mattlokes/mqttDisplay/README.md

# mqttDisplay

## Schematic / BOM
* [BOM](https://htmlpreview.github.io/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)
* [Schematic](https://github.com/mattlokes/mqttDisplay/blob/main/pcb/mqttDisplay/ibom/mqttDisplay.pdf)
