mattlokes/mqttDisplay/case/main.3mf

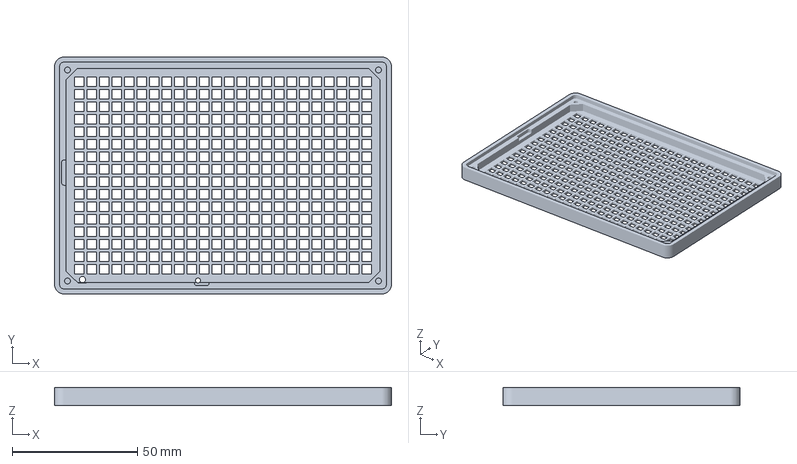
[picture p1: CAD file, 2021-03-28]
case/main.3mf
134.8 x 94.8 x 7.20 mm
