mattlokes/mqttDisplay/case/baffle.stl

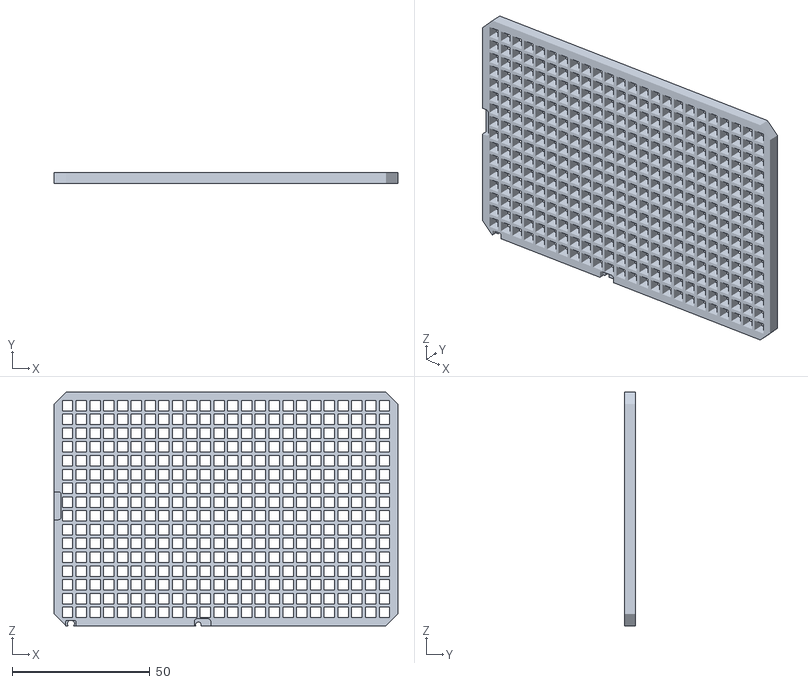
[picture p2: CAD file, 2021-03-28]
case/baffle.stl
124.8 x 4.00 x 84.8
