mattlokes/mqttDisplay/case/stand_right.stl

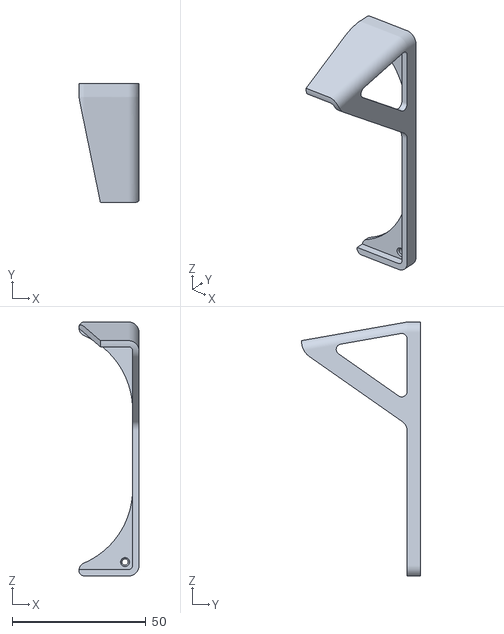
[picture p3: CAD file, 2021-03-28]
case/stand_right.stl
22.4 x 44.4 x 94.8
