mattlokes/mqttDisplay/case/stand.3mf

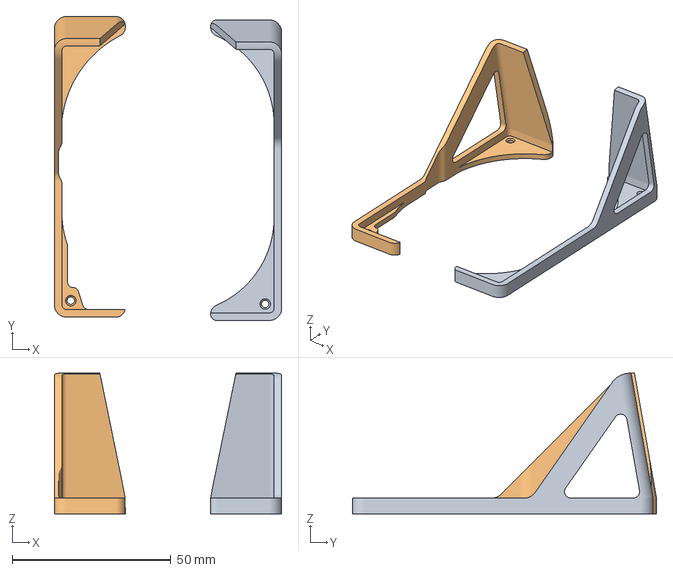
[picture p4: CAD file, 2021-03-28]
case/stand.3mf
71.7 x 95.9 x 44.4 mm
stand_right.stl
stand_left.stl
