mattlokes/mqttDisplay/(list of files, cad)

Other CAD files:
case/stand_left.stl
case/main.stl
