mattlokes/mqttDisplay/pcb/mqttDisplay/mqttDisplay.kicad_pcb

## KiCad design pcb/mqttDisplay/mqttDisplay.kicad_pcb (2021-03-14)

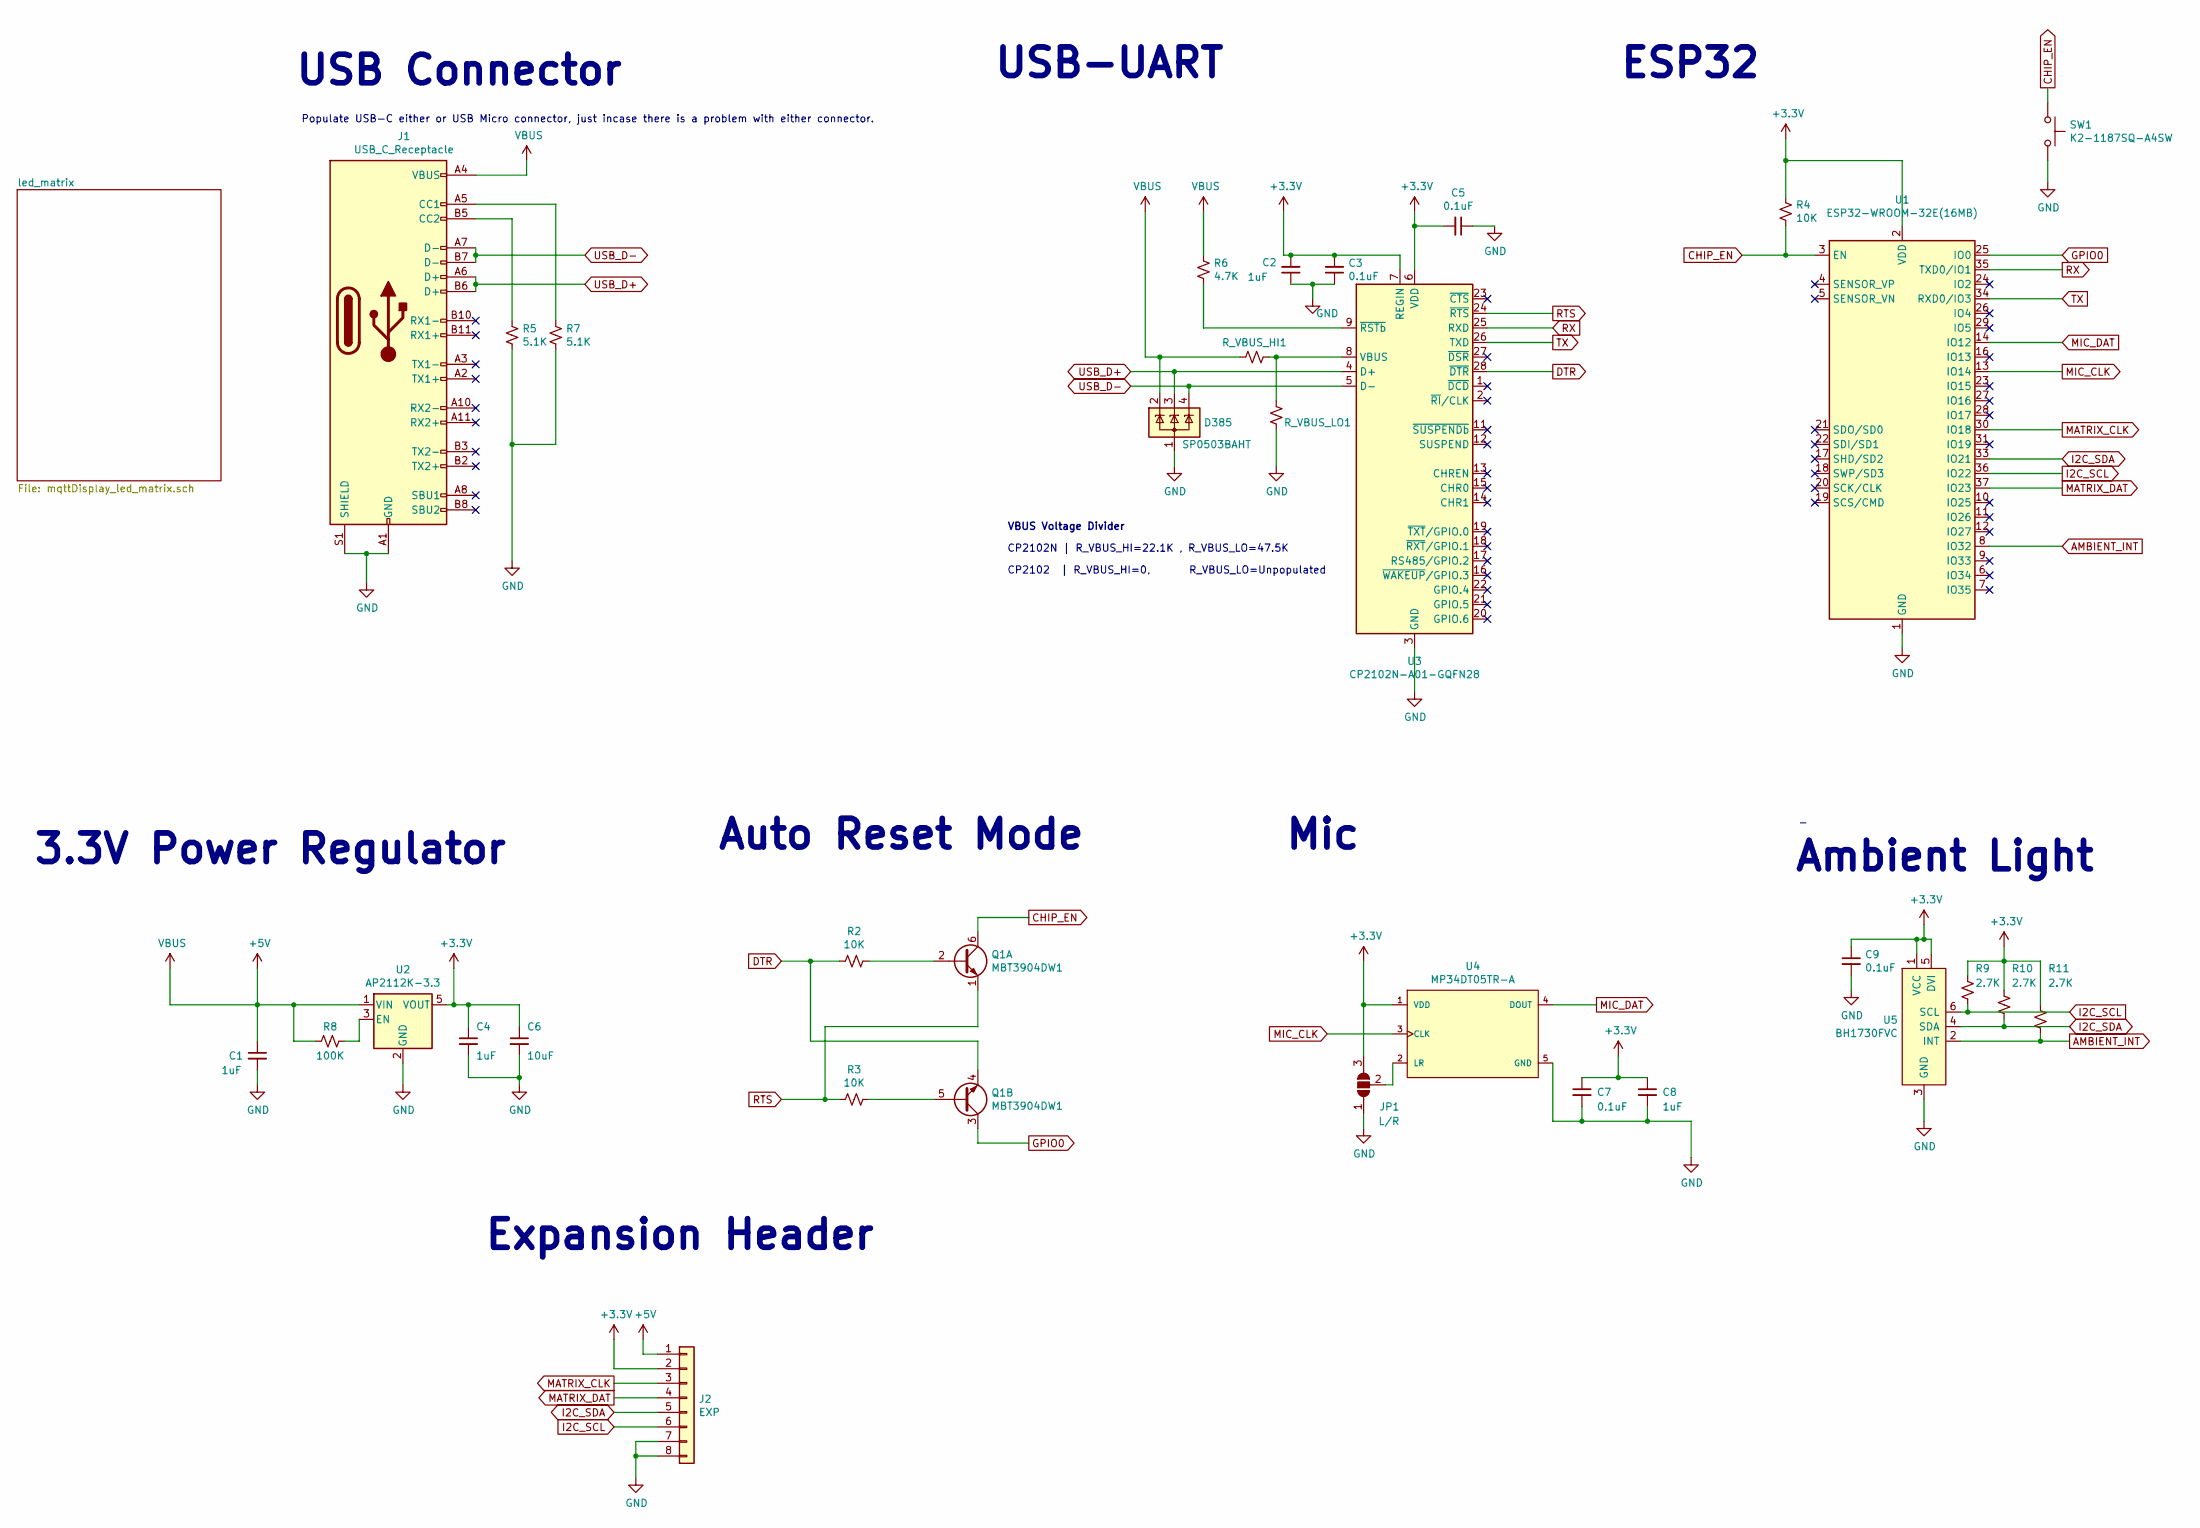
[picture p5: schematic mqttDisplay.sch]

Parts:
C1, C2, C4, C8: 1uF; C_0603_1608Metric_Pad1.08x0.95mm_HandSolder; LCSC# C272771
C3, C5, C7, C9: 0.1uF; C_0603_1608Metric_Pad1.08x0.95mm_HandSolder; LCSC# C478888
C6: 10uF; C_0603_1608Metric_Pad1.08x0.95mm_HandSolder; LCSC# C19702
D385: SP0503BAHT; SOT-143; LCSC# C7074
J1: USB_C_Receptacle; USB_C_Receptacle_JING_EXTENSION_C168704_USB2_VERTICAL; LCSC# C168704
J2: EXP; PinHeader_1x08_P2.54mm_Vertical; LCSC# C50981
JP1: L/R; SolderJumper-3_P1.3mm_Open_RoundedPad1.0x1.5mm; LCSC# --
Q1: MBT3904DW1; SOT-363_SC-70-6; LCSC# C110150
R2, R3, R4: 10K; R_0603_1608Metric_Pad0.98x0.95mm_HandSolder; LCSC# C441897
R5, R7: 5.1K; R_0603_1608Metric_Pad0.98x0.95mm_HandSolder; LCSC# C14677
R6: 4.7K; R_0603_1608Metric_Pad0.98x0.95mm_HandSolder; LCSC# C163915
R8: 100K; R_0603_1608Metric_Pad0.98x0.95mm_HandSolder; LCSC# C189597
R9, R10, R11: 2.7K; R_0603_1608Metric_Pad0.98x0.95mm_HandSolder; LCSC# C403121
R_VBUS_HI1: 0; R_0603_1608Metric_Pad0.98x0.95mm_HandSolder; LCSC# C100044
R_VBUS_LO1: 0; R_0603_1608Metric_Pad0.98x0.95mm_HandSolder; LCSC# C100044
SW1: K2-1187SQ-A4SW; SW_SPST_TL3342; LCSC# C92584
U1: ESP32-WROOM-32E(16MB); ESP32-WROOM-32; LCSC# C701343
U2: AP2112K-3.3; SOT-23-5; LCSC# C51118
U3: CP2102N-A01-GQFN28; QFN-28-1EP_5x5mm_P0.5mm_EP3.35x3.35mm; LCSC# C6568
U4: MP34DT05TR-A; STMicroelectronics-HCLGA-DM00231908-0-3-MFG; mouser part number 511-MP34DT05TR-A; digikey description MICROPHONE MEMS DIGITAL PDM OMNI
U5: BH1730FVC; WSOF6; LCSC# C79616

Connections:
+3V3: C2.2, C3.2, C4.1, C5.2, C6.1, C7.1, C8.1, C9.1, J2.2, JP1.3 (B), R4.1, R9.1, R10.1, R11.1, U1.2 (VDD), U2.5 (VOUT), U3.6 (VDD), U3.7 (REGIN), U4.1 (VDD), U5.1 (VCC), U5.5 (DVI)
+5V: C1.1, D385.2 (K), J1.A4 (VBUS), J1.A9 (VBUS), J1.B4 (VBUS), J1.B9 (VBUS), J2.1, R6.1, R8.2, R_VBUS_HI1.2, U2.1 (VIN); also elsewhere on the board
AMBIENT_INT: R11.2, U1.8 (IO32), U5.2 (INT)
CHIP_EN: Q1.6 (C1), R4.2, SW1.1, U1.3 (EN)
DTR: Q1.4 (E2), R2.2, U3.28 (~DTR)
GND: C1.2, C2.1, C3.1, C4.2, C5.1, C6.2, C7.2, C8.2, C9.2, D385.1 (A), J1.A1 (GND), J1.A12 (GND), J1.B1 (GND), J1.B12 (GND), J1.S1 (SHIELD), J1.SHIELD, J2.7, J2.8, JP1.1 (A), R5.1, R7.1, R_VBUS_LO1.2, SW1.2, U1.1 (GND), U1.15 (GND), U1.38 (GND), U1.39 (GND), U2.2 (GND), U3.3 (GND), U3.29 (GND), U4.5 (GND), U5.3 (GND); also elsewhere on the board
GPIO0: Q1.3 (C2), U1.25 (IO0)
I2C_SCL: J2.6, R9.2, U1.36 (IO22), U5.6 (SCL)
I2C_SDA: J2.5, R10.2, U1.33 (IO21), U5.4 (SDA)
MATRIX_CLK: J2.3, U1.30 (IO18); also elsewhere on the board
MATRIX_DAT: J2.4, U1.37 (IO23); also elsewhere on the board
MIC_CLK: U1.13 (IO14), U4.3 (CLK)
MIC_DAT: U1.14 (IO12), U4.4 (DOUT)
unnamed: J1.A5 (CC1), R7.2
unnamed: J1.B5 (CC2), R5.2
unnamed: JP1.2 (C), U4.2 (LR)
unnamed: Q1.2 (B1), R2.1
unnamed: Q1.5 (B2), R3.1
unnamed: R6.2, U3.9 (~RSTb)
unnamed: R8.1, U2.3 (EN)
unnamed: R_VBUS_HI1.1, R_VBUS_LO1.1, U3.8 (VBUS)
RTS: Q1.1 (E1), R3.2, U3.24 (~RTS)
RX: U1.35 (TXD0/IO1), U3.25 (RXD)
TX: U1.34 (RXD0/IO3), U3.26 (TXD)
USB_D+: D385.3 (K), J1.A6 (D+), J1.B6 (D+), U3.4 (D+)
USB_D-: D385.4 (K), J1.A7 (D-), J1.B7 (D-), U3.5 (D-)

Notes on the sheet:
Expansion Header
Ambient Light
Mic
ESP32
Auto Reset Mode
CP2102 | R_VBUS_HI=0, R_VBUS_LO=Unpopulated
CP2102N | R_VBUS_HI=22.1K , R_VBUS_LO=47.5K
VBUS Voltage Divider
USB-UART
USB Connector
Populate USB-C either or USB Micro connector, just incase there is a problem with either connector.
3.3V Power Regulator
