mattlokes/mqttDisplay/pcb/mqttDisplay/mqttDisplay.kicad_pcb

## KiCad design pcb/mqttDisplay/mqttDisplay.kicad_pcb (continued)

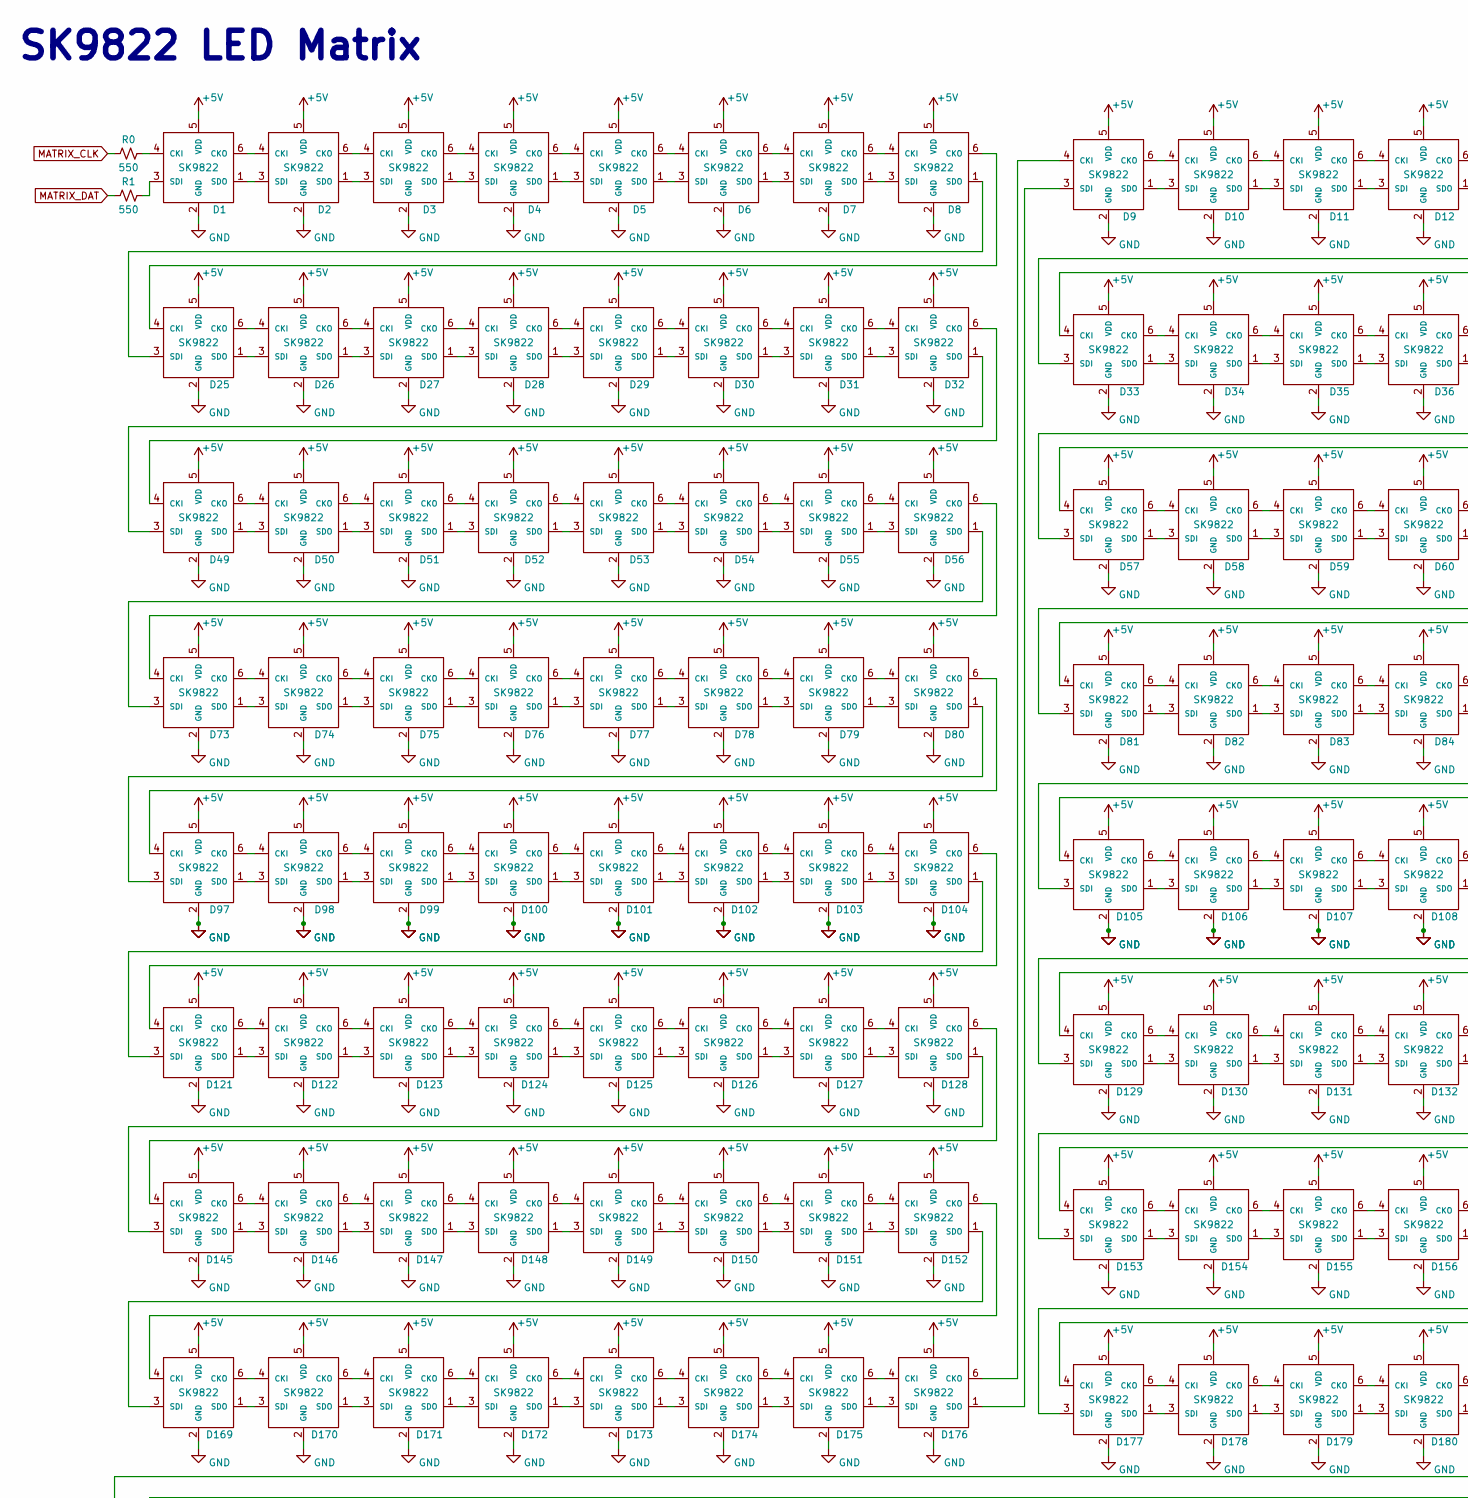
[picture p6: schematic mqttDisplay_led_matrix.sch, part in row 1, column 1]

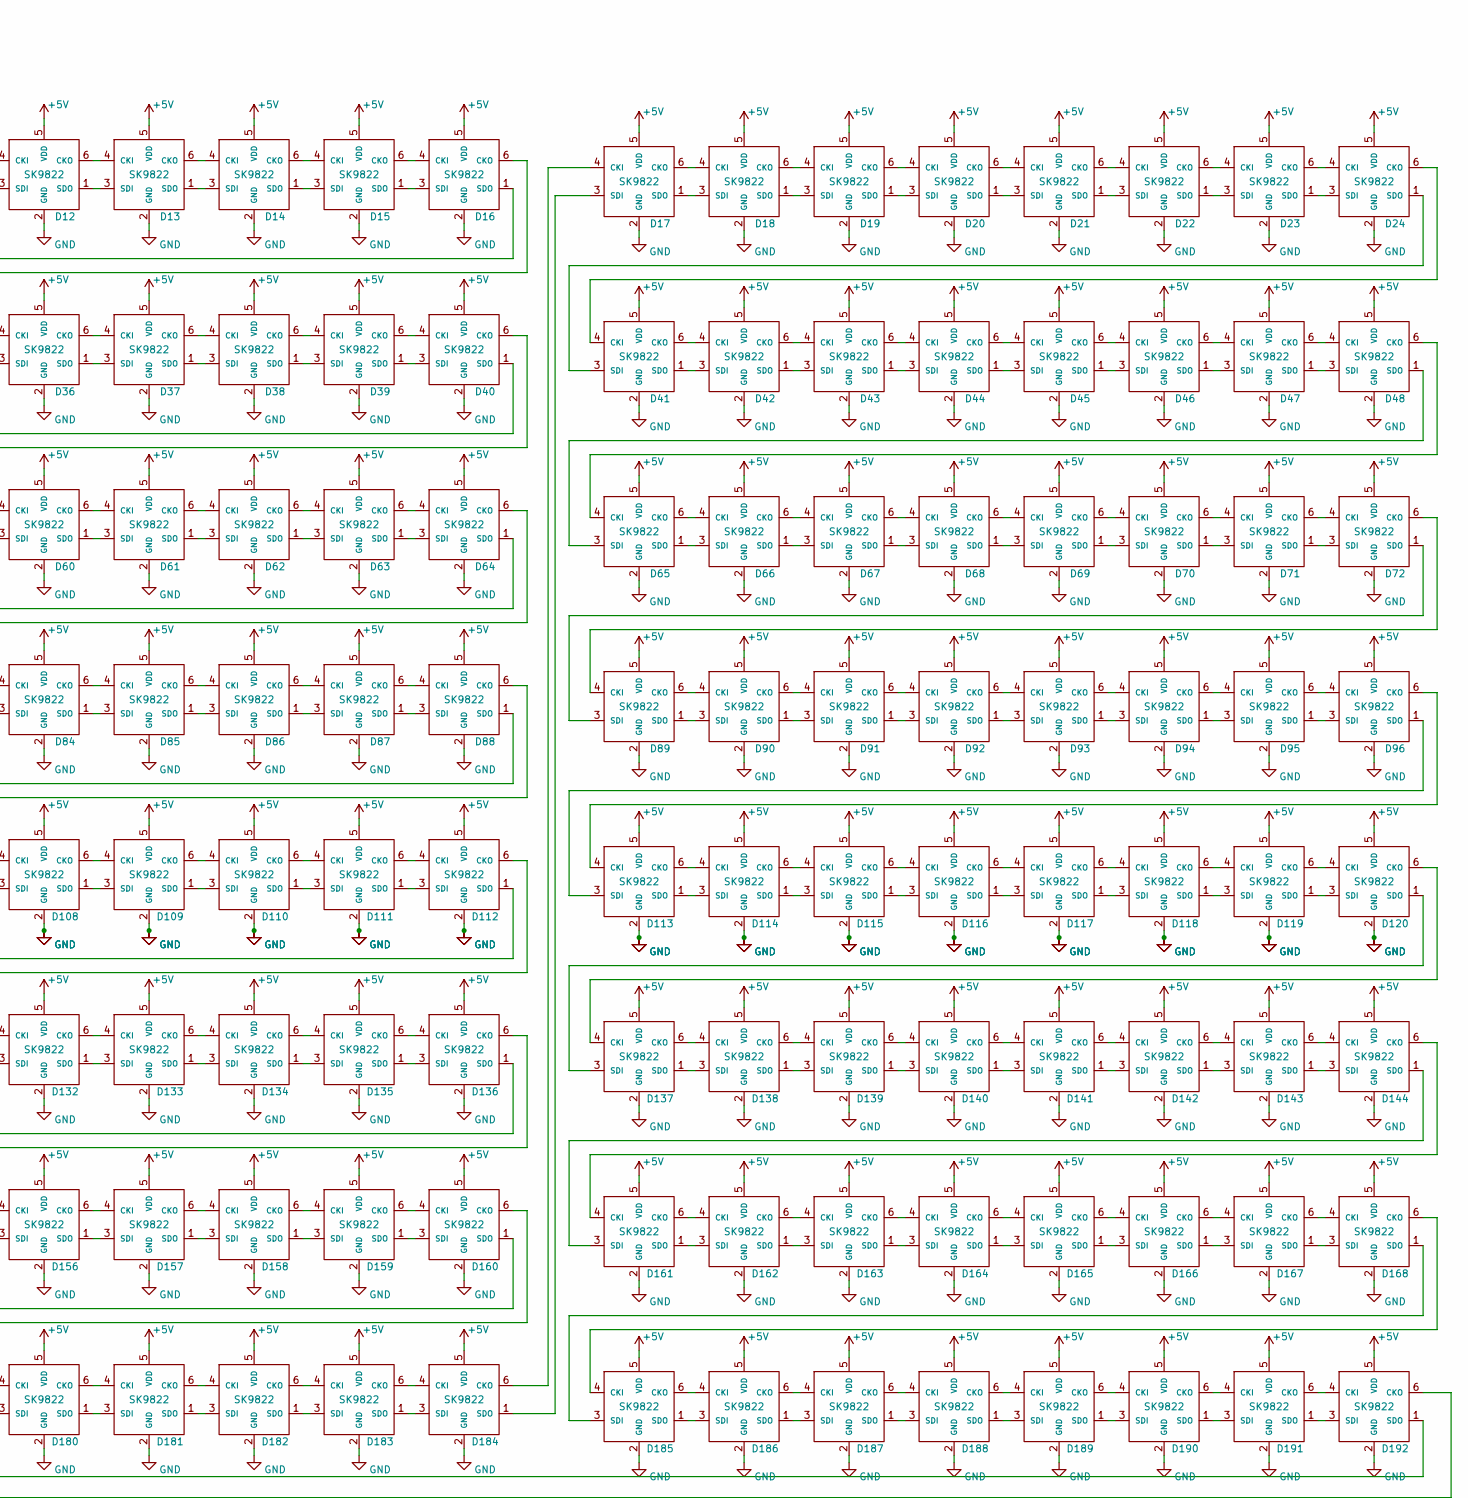
[picture p7: schematic mqttDisplay_led_matrix.sch, part in row 1, column 2]

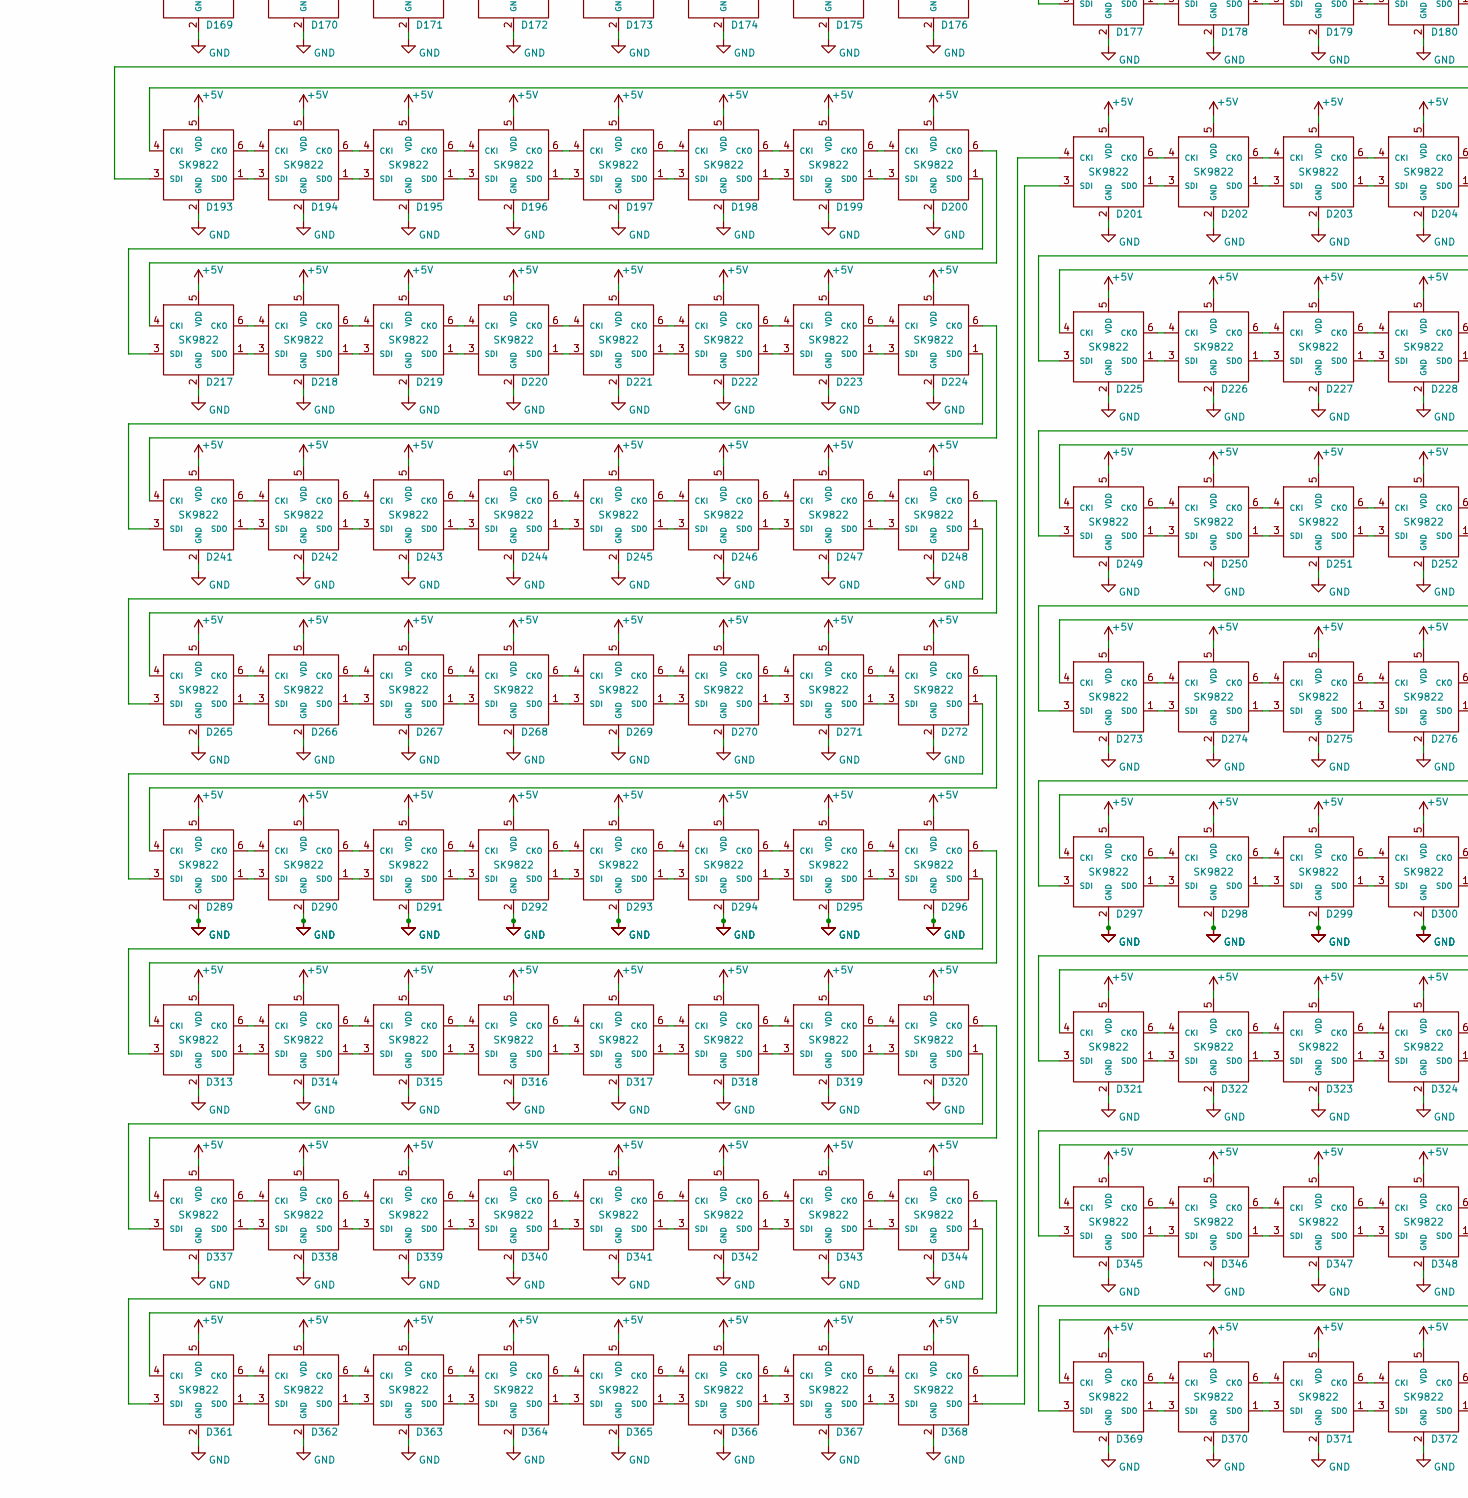
[picture p8: schematic mqttDisplay_led_matrix.sch, part in row 2, column 1]

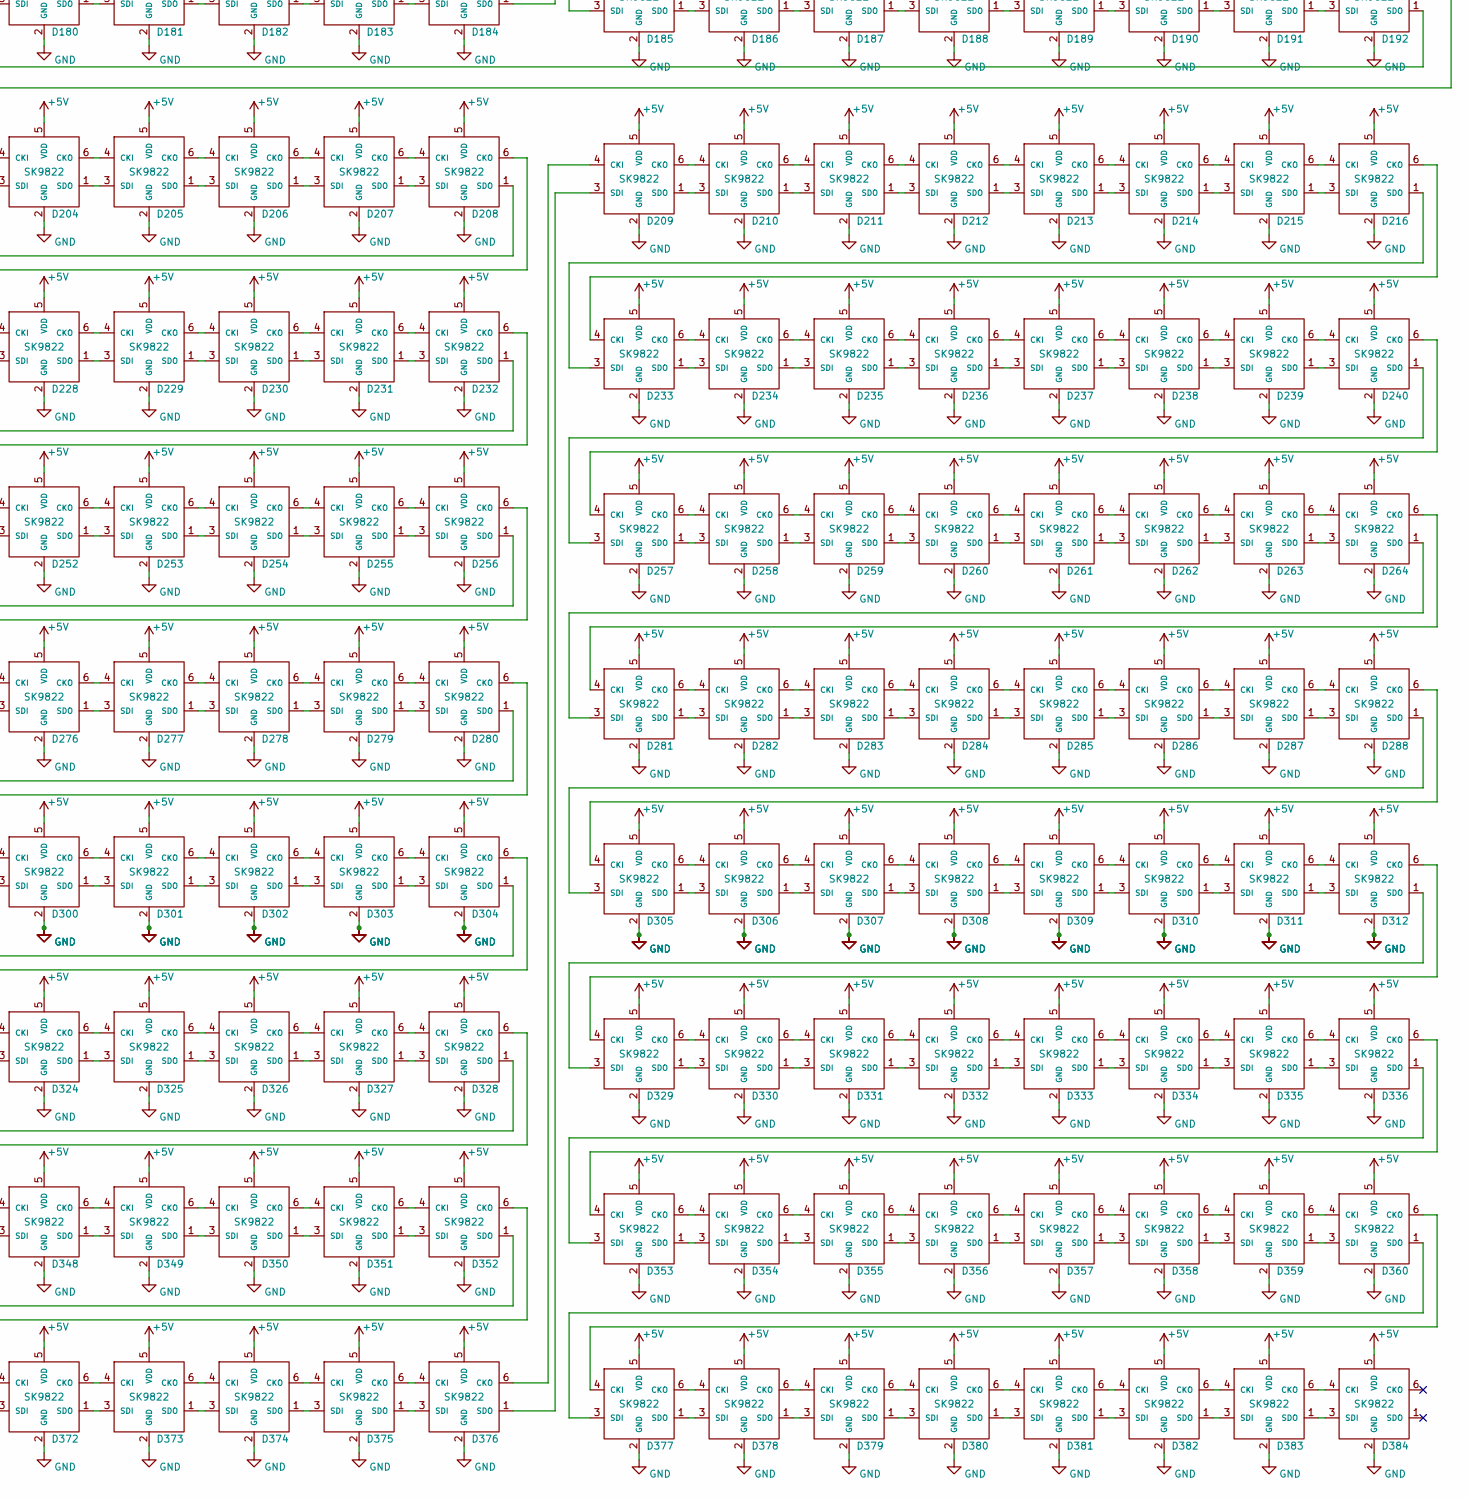
[picture p9: schematic mqttDisplay_led_matrix.sch, part in row 2, column 2]

Parts:
D1, D2, D3, D4, D5, D6, D7, D8, D9, D10, D11, D12, D13, D14, D15, D16, D17, D18, D19, D20, D21, D22, D23, D24, D25, D26, D27, D28, D29, D30, D31, D32, D33, D34, D35, D36, D37, D38, D39, D40, D41, D42, D43, D44, D45, D46, D47, D48, D49, D50, D51, D52, D53, D54, D55, D56, D57, D58, D59, D60, D61, D62, D63, D64, D65, D66, D67, D68, D69, D70, D71, D72, D73, D74, D75, D76, D77, D78, D79, D80, D81, D82, D83, D84, D85, D86, D87, D88, D89, D90, D91, D92, D93, D94, D95, D96, D97, D98, D99, D100, D101, D102, D103, D104, D105, D106, D107, D108, D109, D110, D111, D112, D113, D114, D115, D116, D117, D118, D119, D120, D121, D122, D123, D124, D125, D126, D127, D128, D129, D130, D131, D132, D133, D134, D135, D136, D137, D138, D139, D140, D141, D142, D143, D144, D145, D146, D147, D148, D149, D150, D151, D152, D153, D154, D155, D156, D157, D158, D159, D160, D161, D162, D163, D164, D165, D166, D167, D168, D169, D170, D171, D172, D173, D174, D175, D176, D177, D178, D179, D180, D181, D182, D183, D184, D185, D186, D187, D188, D189, D190, D191, D192, D193, D194, D195, D196, D197, D198, D199, D200, D201, D202, D203, D204, D205, D206, D207, D208, D209, D210, D211, D212, D213, D214, D215, D216, D217, D218, D219, D220, D221, D222, D223, D224, D225, D226, D227, D228, D229, D230, D231, D232, D233, D234, D235, D236, D237, D238, D239, D240, D241, D242, D243, D244, D245, D246, D247, D248, D249, D250, D251, D252, D253, D254, D255, D256, D257, D258, D259, D260, D261, D262, D263, D264, D265, D266, D267, D268, D269, D270, D271, D272, D273, D274, D275, D276, D277, D278, D279, D280, D281, D282, D283, D284, D285, D286, D287, D288, D289, D290, D291, D292, D293, D294, D295, D296, D297, D298, D299, D300, D301, D302, D303, D304, D305, D306, D307, D308, D309, D310, D311, D312, D313, D314, D315, D316, D317, D318, D319, D320, D321, D322, D323, D324, D325, D326, D327, D328, D329, D330, D331, D332, D333, D334, D335, D336, D337, D338, D339, D340, D341, D342, D343, D344, D345, D346, D347, D348, D349, D350, D351, D352, D353, D354, D355, D356, D357, D358, D359, D360, D361, D362, D363, D364, D365, D366, D367, D368, D369, D370, D371, D372, D373, D374, D375, D376, D377, D378, D379, D380, D381, D382, D383, D384: SK9822; LED_SK9822_2020; LCSC# --
R0, R1: 550; R_0603_1608Metric_Pad0.98x0.95mm_HandSolder; LCSC# C308281

Connections:
+5V: D1.5 (VDD), D2.5 (VDD), D3.5 (VDD), D4.5 (VDD), D5.5 (VDD), D6.5 (VDD), D7.5 (VDD), D8.5 (VDD), D9.5 (VDD), D10.5 (VDD), D11.5 (VDD), D12.5 (VDD), D13.5 (VDD), D14.5 (VDD), D15.5 (VDD), D16.5 (VDD), D17.5 (VDD), D18.5 (VDD), D19.5 (VDD), D20.5 (VDD), D21.5 (VDD), D22.5 (VDD), D23.5 (VDD), D24.5 (VDD), D25.5 (VDD), D26.5 (VDD), D27.5 (VDD), D28.5 (VDD), D29.5 (VDD), D30.5 (VDD), D31.5 (VDD), D32.5 (VDD), D33.5 (VDD), D34.5 (VDD), D35.5 (VDD), D36.5 (VDD), D37.5 (VDD), D38.5 (VDD), D39.5 (VDD), D40.5 (VDD), D41.5 (VDD), D42.5 (VDD), D43.5 (VDD), D44.5 (VDD), D45.5 (VDD), D46.5 (VDD), D47.5 (VDD), D48.5 (VDD), D49.5 (VDD), D50.5 (VDD), D51.5 (VDD), D52.5 (VDD), D53.5 (VDD), D54.5 (VDD), D55.5 (VDD), D56.5 (VDD), D57.5 (VDD), D58.5 (VDD), D59.5 (VDD), D60.5 (VDD), D61.5 (VDD), D62.5 (VDD), D63.5 (VDD), D64.5 (VDD), D65.5 (VDD), D66.5 (VDD), D67.5 (VDD), D68.5 (VDD), D69.5 (VDD), D70.5 (VDD), D71.5 (VDD), D72.5 (VDD), D73.5 (VDD), D74.5 (VDD), D75.5 (VDD), D76.5 (VDD), D77.5 (VDD), D78.5 (VDD), D79.5 (VDD), D80.5 (VDD), D81.5 (VDD), D82.5 (VDD), D83.5 (VDD), D84.5 (VDD), D85.5 (VDD), D86.5 (VDD), D87.5 (VDD), D88.5 (VDD), D89.5 (VDD), D90.5 (VDD), D91.5 (VDD), D92.5 (VDD), D93.5 (VDD), D94.5 (VDD), D95.5 (VDD), D96.5 (VDD), D97.5 (VDD), D98.5 (VDD), D99.5 (VDD), D100.5 (VDD), D101.5 (VDD), D102.5 (VDD), D103.5 (VDD), D104.5 (VDD), D105.5 (VDD), D106.5 (VDD), D107.5 (VDD), D108.5 (VDD), D109.5 (VDD), D110.5 (VDD), D111.5 (VDD), D112.5 (VDD), D113.5 (VDD), D114.5 (VDD), D115.5 (VDD), D116.5 (VDD), D117.5 (VDD), D118.5 (VDD), D119.5 (VDD), D120.5 (VDD), D121.5 (VDD), D122.5 (VDD), D123.5 (VDD), D124.5 (VDD), D125.5 (VDD), D126.5 (VDD), D127.5 (VDD), D128.5 (VDD), D129.5 (VDD), D130.5 (VDD), D131.5 (VDD), D132.5 (VDD), D133.5 (VDD), D134.5 (VDD), D135.5 (VDD), D136.5 (VDD), D137.5 (VDD), D138.5 (VDD), D139.5 (VDD), D140.5 (VDD), D141.5 (VDD), D142.5 (VDD), D143.5 (VDD), D144.5 (VDD), D145.5 (VDD), D146.5 (VDD), D147.5 (VDD), D148.5 (VDD), D149.5 (VDD), D150.5 (VDD), D151.5 (VDD), D152.5 (VDD), D153.5 (VDD), D154.5 (VDD), D155.5 (VDD), D156.5 (VDD), D157.5 (VDD), D158.5 (VDD), D159.5 (VDD), D160.5 (VDD), D161.5 (VDD), D162.5 (VDD), D163.5 (VDD), D164.5 (VDD), D165.5 (VDD), D166.5 (VDD), D167.5 (VDD), D168.5 (VDD), D169.5 (VDD), D170.5 (VDD), D171.5 (VDD), D172.5 (VDD), D173.5 (VDD), D174.5 (VDD), D175.5 (VDD), D176.5 (VDD), D177.5 (VDD), D178.5 (VDD), D179.5 (VDD), D180.5 (VDD), D181.5 (VDD), D182.5 (VDD), D183.5 (VDD), D184.5 (VDD), D185.5 (VDD), D186.5 (VDD), D187.5 (VDD), D188.5 (VDD), D189.5 (VDD), D190.5 (VDD), D191.5 (VDD), D192.5 (VDD), D193.5 (VDD), D194.5 (VDD), D195.5 (VDD), D196.5 (VDD), D197.5 (VDD), D198.5 (VDD), D199.5 (VDD), D200.5 (VDD), D201.5 (VDD), D202.5 (VDD), D203.5 (VDD), D204.5 (VDD), D205.5 (VDD), D206.5 (VDD), D207.5 (VDD), D208.5 (VDD), D209.5 (VDD), D210.5 (VDD), D211.5 (VDD), D212.5 (VDD), D213.5 (VDD), D214.5 (VDD), D215.5 (VDD), D216.5 (VDD), D217.5 (VDD), D218.5 (VDD), D219.5 (VDD), D220.5 (VDD), D221.5 (VDD), D222.5 (VDD), D223.5 (VDD), D224.5 (VDD), D225.5 (VDD), D226.5 (VDD), D227.5 (VDD), D228.5 (VDD), D229.5 (VDD), D230.5 (VDD), D231.5 (VDD), D232.5 (VDD), D233.5 (VDD), D234.5 (VDD), D235.5 (VDD), D236.5 (VDD), D237.5 (VDD), D238.5 (VDD), D239.5 (VDD), D240.5 (VDD), D241.5 (VDD), D242.5 (VDD), D243.5 (VDD), D244.5 (VDD), D245.5 (VDD), D246.5 (VDD), D247.5 (VDD), D248.5 (VDD), D249.5 (VDD), D250.5 (VDD), D251.5 (VDD), D252.5 (VDD), D253.5 (VDD), D254.5 (VDD), D255.5 (VDD), D256.5 (VDD), D257.5 (VDD), D258.5 (VDD), D259.5 (VDD), D260.5 (VDD), D261.5 (VDD), D262.5 (VDD), D263.5 (VDD), D264.5 (VDD), D265.5 (VDD), D266.5 (VDD), D267.5 (VDD), D268.5 (VDD), D269.5 (VDD), D270.5 (VDD), D271.5 (VDD), D272.5 (VDD), D273.5 (VDD), D274.5 (VDD), D275.5 (VDD), D276.5 (VDD), D277.5 (VDD), D278.5 (VDD), D279.5 (VDD), D280.5 (VDD), D281.5 (VDD), D282.5 (VDD), D283.5 (VDD), D284.5 (VDD), D285.5 (VDD), D286.5 (VDD), D287.5 (VDD), D288.5 (VDD), D289.5 (VDD), D290.5 (VDD), D291.5 (VDD), D292.5 (VDD), D293.5 (VDD), D294.5 (VDD), D295.5 (VDD), D296.5 (VDD), D297.5 (VDD), D298.5 (VDD), D299.5 (VDD), D300.5 (VDD), D301.5 (VDD), D302.5 (VDD), D303.5 (VDD), D304.5 (VDD), D305.5 (VDD), D306.5 (VDD), D307.5 (VDD), D308.5 (VDD), D309.5 (VDD), D310.5 (VDD), D311.5 (VDD), D312.5 (VDD), D313.5 (VDD), D314.5 (VDD), D315.5 (VDD), D316.5 (VDD), D317.5 (VDD), D318.5 (VDD), D319.5 (VDD), D320.5 (VDD), D321.5 (VDD), D322.5 (VDD), D323.5 (VDD), D324.5 (VDD), D325.5 (VDD), D326.5 (VDD), D327.5 (VDD), D328.5 (VDD), D329.5 (VDD), D330.5 (VDD), D331.5 (VDD), D332.5 (VDD), D333.5 (VDD), D334.5 (VDD), D335.5 (VDD), D336.5 (VDD), D337.5 (VDD), D338.5 (VDD), D339.5 (VDD), D340.5 (VDD), D341.5 (VDD), D342.5 (VDD), D343.5 (VDD), D344.5 (VDD), D345.5 (VDD), D346.5 (VDD), D347.5 (VDD), D348.5 (VDD), D349.5 (VDD), D350.5 (VDD), D351.5 (VDD), D352.5 (VDD), D353.5 (VDD), D354.5 (VDD), D355.5 (VDD), D356.5 (VDD), D357.5 (VDD), D358.5 (VDD), D359.5 (VDD), D360.5 (VDD), D361.5 (VDD), D362.5 (VDD), D363.5 (VDD), D364.5 (VDD), D365.5 (VDD), D366.5 (VDD), D367.5 (VDD), D368.5 (VDD), D369.5 (VDD), D370.5 (VDD), D371.5 (VDD), D372.5 (VDD), D373.5 (VDD), D374.5 (VDD), D375.5 (VDD), D376.5 (VDD), D377.5 (VDD), D378.5 (VDD), D379.5 (VDD), D380.5 (VDD), D381.5 (VDD), D382.5 (VDD), D383.5 (VDD), D384.5 (VDD); also elsewhere on the board
GND: D1.2 (GND), D2.2 (GND), D3.2 (GND), D4.2 (GND), D5.2 (GND), D6.2 (GND), D7.2 (GND), D8.2 (GND), D9.2 (GND), D10.2 (GND), D11.2 (GND), D12.2 (GND), D13.2 (GND), D14.2 (GND), D15.2 (GND), D16.2 (GND), D17.2 (GND), D18.2 (GND), D19.2 (GND), D20.2 (GND), D21.2 (GND), D22.2 (GND), D23.2 (GND), D24.2 (GND), D25.2 (GND), D26.2 (GND), D27.2 (GND), D28.2 (GND), D29.2 (GND), D30.2 (GND), D31.2 (GND), D32.2 (GND), D33.2 (GND), D34.2 (GND), D35.2 (GND), D36.2 (GND), D37.2 (GND), D38.2 (GND), D39.2 (GND), D40.2 (GND), D41.2 (GND), D42.2 (GND), D43.2 (GND), D44.2 (GND), D45.2 (GND), D46.2 (GND), D47.2 (GND), D48.2 (GND), D49.2 (GND), D50.2 (GND), D51.2 (GND), D52.2 (GND), D53.2 (GND), D54.2 (GND), D55.2 (GND), D56.2 (GND), D57.2 (GND), D58.2 (GND), D59.2 (GND), D60.2 (GND), D61.2 (GND), D62.2 (GND), D63.2 (GND), D64.2 (GND), D65.2 (GND), D66.2 (GND), D67.2 (GND), D68.2 (GND), D69.2 (GND), D70.2 (GND), D71.2 (GND), D72.2 (GND), D73.2 (GND), D74.2 (GND), D75.2 (GND), D76.2 (GND), D77.2 (GND), D78.2 (GND), D79.2 (GND), D80.2 (GND), D81.2 (GND), D82.2 (GND), D83.2 (GND), D84.2 (GND), D85.2 (GND), D86.2 (GND), D87.2 (GND), D88.2 (GND), D89.2 (GND), D90.2 (GND), D91.2 (GND), D92.2 (GND), D93.2 (GND), D94.2 (GND), D95.2 (GND), D96.2 (GND), D97.2 (GND), D98.2 (GND), D99.2 (GND), D100.2 (GND), D101.2 (GND), D102.2 (GND), D103.2 (GND), D104.2 (GND), D105.2 (GND), D106.2 (GND), D107.2 (GND), D108.2 (GND), D109.2 (GND), D110.2 (GND), D111.2 (GND), D112.2 (GND), D113.2 (GND), D114.2 (GND), D115.2 (GND), D116.2 (GND), D117.2 (GND), D118.2 (GND), D119.2 (GND), D120.2 (GND), D121.2 (GND), D122.2 (GND), D123.2 (GND), D124.2 (GND), D125.2 (GND), D126.2 (GND), D127.2 (GND), D128.2 (GND), D129.2 (GND), D130.2 (GND), D131.2 (GND), D132.2 (GND), D133.2 (GND), D134.2 (GND), D135.2 (GND), D136.2 (GND), D137.2 (GND), D138.2 (GND), D139.2 (GND), D140.2 (GND), D141.2 (GND), D142.2 (GND), D143.2 (GND), D144.2 (GND), D145.2 (GND), D146.2 (GND), D147.2 (GND), D148.2 (GND), D149.2 (GND), D150.2 (GND), D151.2 (GND), D152.2 (GND), D153.2 (GND), D154.2 (GND), D155.2 (GND), D156.2 (GND), D157.2 (GND), D158.2 (GND), D159.2 (GND), D160.2 (GND), D161.2 (GND), D162.2 (GND), D163.2 (GND), D164.2 (GND), D165.2 (GND), D166.2 (GND), D167.2 (GND), D168.2 (GND), D169.2 (GND), D170.2 (GND), D171.2 (GND), D172.2 (GND), D173.2 (GND), D174.2 (GND), D175.2 (GND), D176.2 (GND), D177.2 (GND), D178.2 (GND), D179.2 (GND), D180.2 (GND), D181.2 (GND), D182.2 (GND), D183.2 (GND), D184.2 (GND), D185.2 (GND), D186.2 (GND), D187.2 (GND), D188.2 (GND), D189.2 (GND), D190.2 (GND), D191.2 (GND), D192.2 (GND), D193.2 (GND), D194.2 (GND), D195.2 (GND), D196.2 (GND), D197.2 (GND), D198.2 (GND), D199.2 (GND), D200.2 (GND), D201.2 (GND), D202.2 (GND), D203.2 (GND), D204.2 (GND), D205.2 (GND), D206.2 (GND), D207.2 (GND), D208.2 (GND), D209.2 (GND), D210.2 (GND), D211.2 (GND), D212.2 (GND), D213.2 (GND), D214.2 (GND), D215.2 (GND), D216.2 (GND), D217.2 (GND), D218.2 (GND), D219.2 (GND), D220.2 (GND), D221.2 (GND), D222.2 (GND), D223.2 (GND), D224.2 (GND), D225.2 (GND), D226.2 (GND), D227.2 (GND), D228.2 (GND), D229.2 (GND), D230.2 (GND), D231.2 (GND), D232.2 (GND), D233.2 (GND), D234.2 (GND), D235.2 (GND), D236.2 (GND), D237.2 (GND), D238.2 (GND), D239.2 (GND), D240.2 (GND), D241.2 (GND), D242.2 (GND), D243.2 (GND), D244.2 (GND), D245.2 (GND), D246.2 (GND), D247.2 (GND), D248.2 (GND), D249.2 (GND), D250.2 (GND), D251.2 (GND), D252.2 (GND), D253.2 (GND), D254.2 (GND), D255.2 (GND), D256.2 (GND), D257.2 (GND), D258.2 (GND), D259.2 (GND), D260.2 (GND), D261.2 (GND), D262.2 (GND), D263.2 (GND), D264.2 (GND), D265.2 (GND), D266.2 (GND), D267.2 (GND), D268.2 (GND), D269.2 (GND), D270.2 (GND), D271.2 (GND), D272.2 (GND), D273.2 (GND), D274.2 (GND), D275.2 (GND), D276.2 (GND), D277.2 (GND), D278.2 (GND), D279.2 (GND), D280.2 (GND), D281.2 (GND), D282.2 (GND), D283.2 (GND), D284.2 (GND), D285.2 (GND), D286.2 (GND), D287.2 (GND), D288.2 (GND), D289.2 (GND), D290.2 (GND), D291.2 (GND), D292.2 (GND), D293.2 (GND), D294.2 (GND), D295.2 (GND), D296.2 (GND), D297.2 (GND), D298.2 (GND), D299.2 (GND), D300.2 (GND), D301.2 (GND), D302.2 (GND), D303.2 (GND), D304.2 (GND), D305.2 (GND), D306.2 (GND), D307.2 (GND), D308.2 (GND), D309.2 (GND), D310.2 (GND), D311.2 (GND), D312.2 (GND), D313.2 (GND), D314.2 (GND), D315.2 (GND), D316.2 (GND), D317.2 (GND), D318.2 (GND), D319.2 (GND), D320.2 (GND), D321.2 (GND), D322.2 (GND), D323.2 (GND), D324.2 (GND), D325.2 (GND), D326.2 (GND), D327.2 (GND), D328.2 (GND), D329.2 (GND), D330.2 (GND), D331.2 (GND), D332.2 (GND), D333.2 (GND), D334.2 (GND), D335.2 (GND), D336.2 (GND), D337.2 (GND), D338.2 (GND), D339.2 (GND), D340.2 (GND), D341.2 (GND), D342.2 (GND), D343.2 (GND), D344.2 (GND), D345.2 (GND), D346.2 (GND), D347.2 (GND), D348.2 (GND), D349.2 (GND), D350.2 (GND), D351.2 (GND), D352.2 (GND), D353.2 (GND), D354.2 (GND), D355.2 (GND), D356.2 (GND), D357.2 (GND), D358.2 (GND), D359.2 (GND), D360.2 (GND), D361.2 (GND), D362.2 (GND), D363.2 (GND), D364.2 (GND), D365.2 (GND), D366.2 (GND), D367.2 (GND), D368.2 (GND), D369.2 (GND), D370.2 (GND), D371.2 (GND), D372.2 (GND), D373.2 (GND), D374.2 (GND), D375.2 (GND), D376.2 (GND), D377.2 (GND), D378.2 (GND), D379.2 (GND), D380.2 (GND), D381.2 (GND), D382.2 (GND), D383.2 (GND), D384.2 (GND); also elsewhere on the board
MATRIX_CLK: R0.2; also elsewhere on the board
MATRIX_DAT: R1.2; also elsewhere on the board
unnamed: D1.1 (SDO), D2.3 (SDI)
unnamed: D1.3 (SDI), R1.1
unnamed: D1.4 (CKI), R0.1
unnamed: D1.6 (CKO), D2.4 (CKI)
unnamed: D2.1 (SDO), D3.3 (SDI)
unnamed: D2.6 (CKO), D3.4 (CKI)
unnamed: D3.1 (SDO), D4.3 (SDI)
unnamed: D3.6 (CKO), D4.4 (CKI)
unnamed: D4.1 (SDO), D5.3 (SDI)
unnamed: D4.6 (CKO), D5.4 (CKI)
unnamed: D5.1 (SDO), D6.3 (SDI)
unnamed: D5.6 (CKO), D6.4 (CKI)
unnamed: D6.1 (SDO), D7.3 (SDI)
unnamed: D6.6 (CKO), D7.4 (CKI)
unnamed: D7.1 (SDO), D8.3 (SDI)
unnamed: D7.6 (CKO), D8.4 (CKI)
unnamed: D10.1 (SDO), D11.3 (SDI)
unnamed: D9.1 (SDO), D10.3 (SDI)
unnamed: D9.6 (CKO), D10.4 (CKI)
unnamed: D10.6 (CKO), D11.4 (CKI)
unnamed: D11.1 (SDO), D12.3 (SDI)
unnamed: D11.6 (CKO), D12.4 (CKI)
unnamed: D12.1 (SDO), D13.3 (SDI)
unnamed: D12.6 (CKO), D13.4 (CKI)
unnamed: D13.1 (SDO), D14.3 (SDI)
unnamed: D13.6 (CKO), D14.4 (CKI)
unnamed: D14.1 (SDO), D15.3 (SDI)
unnamed: D14.6 (CKO), D15.4 (CKI)
unnamed: D15.1 (SDO), D16.3 (SDI)
unnamed: D15.6 (CKO), D16.4 (CKI)
unnamed: D16.1 (SDO), D33.3 (SDI)
unnamed: D16.6 (CKO), D33.4 (CKI)
unnamed: D17.1 (SDO), D18.3 (SDI)
unnamed: D17.3 (SDI), D184.1 (SDO)
unnamed: D17.4 (CKI), D184.6 (CKO)
unnamed: D17.6 (CKO), D18.4 (CKI)
unnamed: D18.1 (SDO), D19.3 (SDI)
unnamed: D18.6 (CKO), D19.4 (CKI)
unnamed: D19.1 (SDO), D20.3 (SDI)
unnamed: D19.6 (CKO), D20.4 (CKI)
unnamed: D20.1 (SDO), D21.3 (SDI)
unnamed: D20.6 (CKO), D21.4 (CKI)
unnamed: D21.1 (SDO), D22.3 (SDI)
unnamed: D21.6 (CKO), D22.4 (CKI)
unnamed: D22.1 (SDO), D23.3 (SDI)
unnamed: D22.6 (CKO), D23.4 (CKI)
unnamed: D23.1 (SDO), D24.3 (SDI)
unnamed: D23.6 (CKO), D24.4 (CKI)
unnamed: D24.1 (SDO), D41.3 (SDI)
unnamed: D24.6 (CKO), D41.4 (CKI)
unnamed: D25.1 (SDO), D26.3 (SDI)
unnamed: D8.1 (SDO), D25.3 (SDI)
unnamed: D8.6 (CKO), D25.4 (CKI)
unnamed: D25.6 (CKO), D26.4 (CKI)
unnamed: D26.1 (SDO), D27.3 (SDI)
unnamed: D26.6 (CKO), D27.4 (CKI)
unnamed: D27.1 (SDO), D28.3 (SDI)
unnamed: D27.6 (CKO), D28.4 (CKI)
unnamed: D28.1 (SDO), D29.3 (SDI)
unnamed: D28.6 (CKO), D29.4 (CKI)
unnamed: D29.1 (SDO), D30.3 (SDI)
unnamed: D29.6 (CKO), D30.4 (CKI)
unnamed: D30.1 (SDO), D31.3 (SDI)
unnamed: D30.6 (CKO), D31.4 (CKI)
unnamed: D31.1 (SDO), D32.3 (SDI)
unnamed: D31.6 (CKO), D32.4 (CKI)
unnamed: D32.1 (SDO), D49.3 (SDI)
unnamed: D32.6 (CKO), D49.4 (CKI)
unnamed: D33.1 (SDO), D34.3 (SDI)
unnamed: D33.6 (CKO), D34.4 (CKI)
unnamed: D34.1 (SDO), D35.3 (SDI)
unnamed: D34.6 (CKO), D35.4 (CKI)
unnamed: D35.1 (SDO), D36.3 (SDI)
unnamed: D35.6 (CKO), D36.4 (CKI)
unnamed: D36.1 (SDO), D37.3 (SDI)
unnamed: D36.6 (CKO), D37.4 (CKI)
unnamed: D37.1 (SDO), D38.3 (SDI)
unnamed: D37.6 (CKO), D38.4 (CKI)
unnamed: D38.1 (SDO), D39.3 (SDI)
unnamed: D38.6 (CKO), D39.4 (CKI)
unnamed: D39.1 (SDO), D40.3 (SDI)
unnamed: D39.6 (CKO), D40.4 (CKI)
unnamed: D40.1 (SDO), D57.3 (SDI)
unnamed: D40.6 (CKO), D57.4 (CKI)
unnamed: D41.1 (SDO), D42.3 (SDI)
unnamed: D41.6 (CKO), D42.4 (CKI)
unnamed: D42.1 (SDO), D43.3 (SDI)
unnamed: D42.6 (CKO), D43.4 (CKI)
unnamed: D43.1 (SDO), D44.3 (SDI)
unnamed: D43.6 (CKO), D44.4 (CKI)
unnamed: D44.1 (SDO), D45.3 (SDI)
unnamed: D44.6 (CKO), D45.4 (CKI)
unnamed: D45.1 (SDO), D46.3 (SDI)
unnamed: D45.6 (CKO), D46.4 (CKI)
unnamed: D46.1 (SDO), D47.3 (SDI)
unnamed: D46.6 (CKO), D47.4 (CKI)
unnamed: D47.1 (SDO), D48.3 (SDI)
unnamed: D47.6 (CKO), D48.4 (CKI)
unnamed: D48.1 (SDO), D65.3 (SDI)
unnamed: D48.6 (CKO), D65.4 (CKI)
unnamed: D49.1 (SDO), D50.3 (SDI)
unnamed: D49.6 (CKO), D50.4 (CKI)
unnamed: D50.1 (SDO), D51.3 (SDI)
unnamed: D50.6 (CKO), D51.4 (CKI)
unnamed: D51.1 (SDO), D52.3 (SDI)
unnamed: D51.6 (CKO), D52.4 (CKI)
unnamed: D52.1 (SDO), D53.3 (SDI)
unnamed: D52.6 (CKO), D53.4 (CKI)
unnamed: D53.1 (SDO), D54.3 (SDI)
unnamed: D53.6 (CKO), D54.4 (CKI)
unnamed: D54.1 (SDO), D55.3 (SDI)
unnamed: D54.6 (CKO), D55.4 (CKI)
unnamed: D55.1 (SDO), D56.3 (SDI)
unnamed: D55.6 (CKO), D56.4 (CKI)
unnamed: D56.1 (SDO), D73.3 (SDI)
unnamed: D56.6 (CKO), D73.4 (CKI)
unnamed: D57.1 (SDO), D58.3 (SDI)
unnamed: D57.6 (CKO), D58.4 (CKI)
unnamed: D58.1 (SDO), D59.3 (SDI)
unnamed: D58.6 (CKO), D59.4 (CKI)
unnamed: D59.1 (SDO), D60.3 (SDI)
unnamed: D59.6 (CKO), D60.4 (CKI)
unnamed: D60.1 (SDO), D61.3 (SDI)
unnamed: D60.6 (CKO), D61.4 (CKI)
unnamed: D61.1 (SDO), D62.3 (SDI)
unnamed: D61.6 (CKO), D62.4 (CKI)
unnamed: D62.1 (SDO), D63.3 (SDI)
unnamed: D62.6 (CKO), D63.4 (CKI)
unnamed: D63.1 (SDO), D64.3 (SDI)
unnamed: D63.6 (CKO), D64.4 (CKI)
unnamed: D64.1 (SDO), D81.3 (SDI)
unnamed: D64.6 (CKO), D81.4 (CKI)
unnamed: D65.1 (SDO), D66.3 (SDI)
unnamed: D65.6 (CKO), D66.4 (CKI)
unnamed: D66.1 (SDO), D67.3 (SDI)
unnamed: D66.6 (CKO), D67.4 (CKI)
unnamed: D67.1 (SDO), D68.3 (SDI)
unnamed: D67.6 (CKO), D68.4 (CKI)
unnamed: D68.1 (SDO), D69.3 (SDI)
unnamed: D68.6 (CKO), D69.4 (CKI)
unnamed: D69.1 (SDO), D70.3 (SDI)
unnamed: D69.6 (CKO), D70.4 (CKI)
unnamed: D70.1 (SDO), D71.3 (SDI)
unnamed: D70.6 (CKO), D71.4 (CKI)
unnamed: D71.1 (SDO), D72.3 (SDI)
unnamed: D71.6 (CKO), D72.4 (CKI)
unnamed: D72.1 (SDO), D89.3 (SDI)
unnamed: D72.6 (CKO), D89.4 (CKI)
unnamed: D73.1 (SDO), D74.3 (SDI)
unnamed: D73.6 (CKO), D74.4 (CKI)
unnamed: D74.1 (SDO), D75.3 (SDI)
unnamed: D74.6 (CKO), D75.4 (CKI)
unnamed: D75.1 (SDO), D76.3 (SDI)
unnamed: D75.6 (CKO), D76.4 (CKI)
unnamed: D76.1 (SDO), D77.3 (SDI)
unnamed: D76.6 (CKO), D77.4 (CKI)
unnamed: D77.1 (SDO), D78.3 (SDI)
unnamed: D77.6 (CKO), D78.4 (CKI)
unnamed: D78.1 (SDO), D79.3 (SDI)
unnamed: D78.6 (CKO), D79.4 (CKI)
unnamed: D79.1 (SDO), D80.3 (SDI)
unnamed: D79.6 (CKO), D80.4 (CKI)
unnamed: D80.1 (SDO), D97.3 (SDI)
unnamed: D80.6 (CKO), D97.4 (CKI)
unnamed: D81.1 (SDO), D82.3 (SDI)
unnamed: D81.6 (CKO), D82.4 (CKI)
unnamed: D82.1 (SDO), D83.3 (SDI)
unnamed: D82.6 (CKO), D83.4 (CKI)
unnamed: D83.1 (SDO), D84.3 (SDI)
unnamed: D83.6 (CKO), D84.4 (CKI)
unnamed: D84.1 (SDO), D85.3 (SDI)
unnamed: D84.6 (CKO), D85.4 (CKI)
unnamed: D85.1 (SDO), D86.3 (SDI)
unnamed: D85.6 (CKO), D86.4 (CKI)
unnamed: D86.1 (SDO), D87.3 (SDI)
unnamed: D86.6 (CKO), D87.4 (CKI)
unnamed: D87.1 (SDO), D88.3 (SDI)
unnamed: D87.6 (CKO), D88.4 (CKI)
unnamed: D89.1 (SDO), D90.3 (SDI)
unnamed: D89.6 (CKO), D90.4 (CKI)
unnamed: D90.1 (SDO), D91.3 (SDI)
unnamed: D90.6 (CKO), D91.4 (CKI)
unnamed: D91.1 (SDO), D92.3 (SDI)
unnamed: D91.6 (CKO), D92.4 (CKI)
unnamed: D92.1 (SDO), D93.3 (SDI)
unnamed: D92.6 (CKO), D93.4 (CKI)
unnamed: D93.1 (SDO), D94.3 (SDI)
unnamed: D93.6 (CKO), D94.4 (CKI)
unnamed: D94.1 (SDO), D95.3 (SDI)
unnamed: D94.6 (CKO), D95.4 (CKI)
unnamed: D95.1 (SDO), D96.3 (SDI)
unnamed: D95.6 (CKO), D96.4 (CKI)
unnamed: D97.1 (SDO), D98.3 (SDI)
unnamed: D97.6 (CKO), D98.4 (CKI)
unnamed: D98.1 (SDO), D99.3 (SDI)
unnamed: D98.6 (CKO), D99.4 (CKI)
unnamed: D100.1 (SDO), D101.3 (SDI)
unnamed: D99.1 (SDO), D100.3 (SDI)
unnamed: D99.6 (CKO), D100.4 (CKI)
unnamed: D100.6 (CKO), D101.4 (CKI)
unnamed: D101.1 (SDO), D102.3 (SDI)
unnamed: D101.6 (CKO), D102.4 (CKI)
unnamed: D102.1 (SDO), D103.3 (SDI)
unnamed: D102.6 (CKO), D103.4 (CKI)
unnamed: D103.1 (SDO), D104.3 (SDI)
unnamed: D103.6 (CKO), D104.4 (CKI)
unnamed: D104.1 (SDO), D121.3 (SDI)
unnamed: D104.6 (CKO), D121.4 (CKI)
unnamed: D105.1 (SDO), D106.3 (SDI)
unnamed: D88.1 (SDO), D105.3 (SDI)
unnamed: D88.6 (CKO), D105.4 (CKI)
unnamed: D105.6 (CKO), D106.4 (CKI)
unnamed: D106.1 (SDO), D107.3 (SDI)
unnamed: D106.6 (CKO), D107.4 (CKI)
unnamed: D107.1 (SDO), D108.3 (SDI)
unnamed: D107.6 (CKO), D108.4 (CKI)
unnamed: D108.1 (SDO), D109.3 (SDI)
unnamed: D108.6 (CKO), D109.4 (CKI)
unnamed: D109.1 (SDO), D110.3 (SDI)
unnamed: D109.6 (CKO), D110.4 (CKI)
unnamed: D110.1 (SDO), D111.3 (SDI)
unnamed: D110.6 (CKO), D111.4 (CKI)
unnamed: D111.1 (SDO), D112.3 (SDI)
unnamed: D111.6 (CKO), D112.4 (CKI)
unnamed: D112.1 (SDO), D129.3 (SDI)
unnamed: D112.6 (CKO), D129.4 (CKI)
unnamed: D113.1 (SDO), D114.3 (SDI)
unnamed: D96.1 (SDO), D113.3 (SDI)
unnamed: D96.6 (CKO), D113.4 (CKI)
unnamed: D113.6 (CKO), D114.4 (CKI)
unnamed: D114.1 (SDO), D115.3 (SDI)
unnamed: D114.6 (CKO), D115.4 (CKI)
unnamed: D115.1 (SDO), D116.3 (SDI)
unnamed: D115.6 (CKO), D116.4 (CKI)
unnamed: D116.1 (SDO), D117.3 (SDI)
unnamed: D116.6 (CKO), D117.4 (CKI)
unnamed: D117.1 (SDO), D118.3 (SDI)
unnamed: D117.6 (CKO), D118.4 (CKI)
unnamed: D118.1 (SDO), D119.3 (SDI)
unnamed: D118.6 (CKO), D119.4 (CKI)
unnamed: D119.1 (SDO), D120.3 (SDI)
unnamed: D119.6 (CKO), D120.4 (CKI)
unnamed: D120.1 (SDO), D137.3 (SDI)
unnamed: D120.6 (CKO), D137.4 (CKI)
unnamed: D121.1 (SDO), D122.3 (SDI)
unnamed: D121.6 (CKO), D122.4 (CKI)
unnamed: D122.1 (SDO), D123.3 (SDI)
unnamed: D122.6 (CKO), D123.4 (CKI)
unnamed: D123.1 (SDO), D124.3 (SDI)
unnamed: D123.6 (CKO), D124.4 (CKI)
unnamed: D124.1 (SDO), D125.3 (SDI)
unnamed: D124.6 (CKO), D125.4 (CKI)
unnamed: D125.1 (SDO), D126.3 (SDI)
unnamed: D125.6 (CKO), D126.4 (CKI)
unnamed: D126.1 (SDO), D127.3 (SDI)
unnamed: D126.6 (CKO), D127.4 (CKI)
unnamed: D127.1 (SDO), D128.3 (SDI)
unnamed: D127.6 (CKO), D128.4 (CKI)
unnamed: D128.1 (SDO), D145.3 (SDI)
unnamed: D128.6 (CKO), D145.4 (CKI)
unnamed: D129.1 (SDO), D130.3 (SDI)
unnamed: D129.6 (CKO), D130.4 (CKI)
unnamed: D130.1 (SDO), D131.3 (SDI)
unnamed: D130.6 (CKO), D131.4 (CKI)
unnamed: D131.1 (SDO), D132.3 (SDI)
unnamed: D131.6 (CKO), D132.4 (CKI)
unnamed: D132.1 (SDO), D133.3 (SDI)
unnamed: D132.6 (CKO), D133.4 (CKI)
unnamed: D133.1 (SDO), D134.3 (SDI)
unnamed: D133.6 (CKO), D134.4 (CKI)
unnamed: D134.1 (SDO), D135.3 (SDI)
unnamed: D134.6 (CKO), D135.4 (CKI)
unnamed: D135.1 (SDO), D136.3 (SDI)
unnamed: D135.6 (CKO), D136.4 (CKI)
unnamed: D136.1 (SDO), D153.3 (SDI)
unnamed: D136.6 (CKO), D153.4 (CKI)
unnamed: D137.1 (SDO), D138.3 (SDI)
unnamed: D137.6 (CKO), D138.4 (CKI)
unnamed: D138.1 (SDO), D139.3 (SDI)
unnamed: D138.6 (CKO), D139.4 (CKI)
unnamed: D139.1 (SDO), D140.3 (SDI)
unnamed: D139.6 (CKO), D140.4 (CKI)
unnamed: D140.1 (SDO), D141.3 (SDI)
unnamed: D140.6 (CKO), D141.4 (CKI)
unnamed: D141.1 (SDO), D142.3 (SDI)
unnamed: D141.6 (CKO), D142.4 (CKI)
unnamed: D142.1 (SDO), D143.3 (SDI)
unnamed: D142.6 (CKO), D143.4 (CKI)
unnamed: D143.1 (SDO), D144.3 (SDI)
unnamed: D143.6 (CKO), D144.4 (CKI)
unnamed: D144.1 (SDO), D161.3 (SDI)
unnamed: D144.6 (CKO), D161.4 (CKI)
unnamed: D145.1 (SDO), D146.3 (SDI)
unnamed: D145.6 (CKO), D146.4 (CKI)
unnamed: D146.1 (SDO), D147.3 (SDI)
unnamed: D146.6 (CKO), D147.4 (CKI)
unnamed: D147.1 (SDO), D148.3 (SDI)
unnamed: D147.6 (CKO), D148.4 (CKI)
unnamed: D148.1 (SDO), D149.3 (SDI)
unnamed: D148.6 (CKO), D149.4 (CKI)
unnamed: D149.1 (SDO), D150.3 (SDI)
unnamed: D149.6 (CKO), D150.4 (CKI)
unnamed: D150.1 (SDO), D151.3 (SDI)
unnamed: D150.6 (CKO), D151.4 (CKI)
unnamed: D151.1 (SDO), D152.3 (SDI)
unnamed: D151.6 (CKO), D152.4 (CKI)
unnamed: D152.1 (SDO), D169.3 (SDI)
unnamed: D152.6 (CKO), D169.4 (CKI)
unnamed: D153.1 (SDO), D154.3 (SDI)
unnamed: D153.6 (CKO), D154.4 (CKI)
unnamed: D154.1 (SDO), D155.3 (SDI)
unnamed: D154.6 (CKO), D155.4 (CKI)
unnamed: D155.1 (SDO), D156.3 (SDI)
unnamed: D155.6 (CKO), D156.4 (CKI)
unnamed: D156.1 (SDO), D157.3 (SDI)
unnamed: D156.6 (CKO), D157.4 (CKI)
unnamed: D157.1 (SDO), D158.3 (SDI)
unnamed: D157.6 (CKO), D158.4 (CKI)
unnamed: D158.1 (SDO), D159.3 (SDI)
unnamed: D158.6 (CKO), D159.4 (CKI)
unnamed: D159.1 (SDO), D160.3 (SDI)
unnamed: D159.6 (CKO), D160.4 (CKI)
unnamed: D160.1 (SDO), D177.3 (SDI)
unnamed: D160.6 (CKO), D177.4 (CKI)
unnamed: D161.1 (SDO), D162.3 (SDI)
unnamed: D161.6 (CKO), D162.4 (CKI)
unnamed: D162.1 (SDO), D163.3 (SDI)
unnamed: D162.6 (CKO), D163.4 (CKI)
unnamed: D163.1 (SDO), D164.3 (SDI)
unnamed: D163.6 (CKO), D164.4 (CKI)
unnamed: D164.1 (SDO), D165.3 (SDI)
unnamed: D164.6 (CKO), D165.4 (CKI)
unnamed: D165.1 (SDO), D166.3 (SDI)
unnamed: D165.6 (CKO), D166.4 (CKI)
unnamed: D166.1 (SDO), D167.3 (SDI)
unnamed: D166.6 (CKO), D167.4 (CKI)
unnamed: D167.1 (SDO), D168.3 (SDI)
unnamed: D167.6 (CKO), D168.4 (CKI)
unnamed: D168.1 (SDO), D185.3 (SDI)
unnamed: D168.6 (CKO), D185.4 (CKI)
unnamed: D169.1 (SDO), D170.3 (SDI)
unnamed: D169.6 (CKO), D170.4 (CKI)
unnamed: D170.1 (SDO), D171.3 (SDI)
unnamed: D170.6 (CKO), D171.4 (CKI)
unnamed: D171.1 (SDO), D172.3 (SDI)
unnamed: D171.6 (CKO), D172.4 (CKI)
unnamed: D172.1 (SDO), D173.3 (SDI)
unnamed: D172.6 (CKO), D173.4 (CKI)
unnamed: D173.1 (SDO), D174.3 (SDI)
unnamed: D173.6 (CKO), D174.4 (CKI)
unnamed: D174.1 (SDO), D175.3 (SDI)
unnamed: D174.6 (CKO), D175.4 (CKI)
unnamed: D175.1 (SDO), D176.3 (SDI)
unnamed: D175.6 (CKO), D176.4 (CKI)
unnamed: D9.3 (SDI), D176.1 (SDO)
unnamed: D9.4 (CKI), D176.6 (CKO)
unnamed: D177.1 (SDO), D178.3 (SDI)
unnamed: D177.6 (CKO), D178.4 (CKI)
unnamed: D178.1 (SDO), D179.3 (SDI)
unnamed: D178.6 (CKO), D179.4 (CKI)
unnamed: D179.1 (SDO), D180.3 (SDI)
unnamed: D179.6 (CKO), D180.4 (CKI)
unnamed: D180.1 (SDO), D181.3 (SDI)
unnamed: D180.6 (CKO), D181.4 (CKI)
unnamed: D181.1 (SDO), D182.3 (SDI)
unnamed: D181.6 (CKO), D182.4 (CKI)
unnamed: D182.1 (SDO), D183.3 (SDI)
unnamed: D182.6 (CKO), D183.4 (CKI)
unnamed: D183.1 (SDO), D184.3 (SDI)
unnamed: D183.6 (CKO), D184.4 (CKI)
unnamed: D185.1 (SDO), D186.3 (SDI)
unnamed: D185.6 (CKO), D186.4 (CKI)
unnamed: D186.1 (SDO), D187.3 (SDI)
unnamed: D186.6 (CKO), D187.4 (CKI)
unnamed: D187.1 (SDO), D188.3 (SDI)
unnamed: D187.6 (CKO), D188.4 (CKI)
unnamed: D188.1 (SDO), D189.3 (SDI)
unnamed: D188.6 (CKO), D189.4 (CKI)
unnamed: D189.1 (SDO), D190.3 (SDI)
unnamed: D189.6 (CKO), D190.4 (CKI)
unnamed: D190.1 (SDO), D191.3 (SDI)
unnamed: D190.6 (CKO), D191.4 (CKI)
unnamed: D191.1 (SDO), D192.3 (SDI)
unnamed: D191.6 (CKO), D192.4 (CKI)
unnamed: D192.1 (SDO), D193.3 (SDI)
unnamed: D192.6 (CKO), D193.4 (CKI)
unnamed: D193.1 (SDO), D194.3 (SDI)
unnamed: D193.6 (CKO), D194.4 (CKI)
unnamed: D194.1 (SDO), D195.3 (SDI)
unnamed: D194.6 (CKO), D195.4 (CKI)
unnamed: D195.1 (SDO), D196.3 (SDI)
unnamed: D195.6 (CKO), D196.4 (CKI)
unnamed: D196.1 (SDO), D197.3 (SDI)
unnamed: D196.6 (CKO), D197.4 (CKI)
unnamed: D197.1 (SDO), D198.3 (SDI)
unnamed: D197.6 (CKO), D198.4 (CKI)
unnamed: D198.1 (SDO), D199.3 (SDI)
unnamed: D198.6 (CKO), D199.4 (CKI)
unnamed: D199.1 (SDO), D200.3 (SDI)
unnamed: D199.6 (CKO), D200.4 (CKI)
unnamed: D200.1 (SDO), D217.3 (SDI)
unnamed: D200.6 (CKO), D217.4 (CKI)
unnamed: D201.1 (SDO), D202.3 (SDI)
unnamed: D201.3 (SDI), D368.1 (SDO)
unnamed: D201.4 (CKI), D368.6 (CKO)
unnamed: D201.6 (CKO), D202.4 (CKI)
unnamed: D202.1 (SDO), D203.3 (SDI)
unnamed: D202.6 (CKO), D203.4 (CKI)
unnamed: D203.1 (SDO), D204.3 (SDI)
unnamed: D203.6 (CKO), D204.4 (CKI)
unnamed: D204.1 (SDO), D205.3 (SDI)
unnamed: D204.6 (CKO), D205.4 (CKI)
unnamed: D205.1 (SDO), D206.3 (SDI)
unnamed: D205.6 (CKO), D206.4 (CKI)
unnamed: D206.1 (SDO), D207.3 (SDI)
unnamed: D206.6 (CKO), D207.4 (CKI)
unnamed: D207.1 (SDO), D208.3 (SDI)
unnamed: D207.6 (CKO), D208.4 (CKI)
unnamed: D208.1 (SDO), D225.3 (SDI)
unnamed: D208.6 (CKO), D225.4 (CKI)
unnamed: D209.1 (SDO), D210.3 (SDI)
unnamed: D209.3 (SDI), D376.1 (SDO)
unnamed: D209.4 (CKI), D376.6 (CKO)
unnamed: D209.6 (CKO), D210.4 (CKI)
unnamed: D210.1 (SDO), D211.3 (SDI)
unnamed: D210.6 (CKO), D211.4 (CKI)
unnamed: D211.1 (SDO), D212.3 (SDI)
unnamed: D211.6 (CKO), D212.4 (CKI)
unnamed: D212.1 (SDO), D213.3 (SDI)
unnamed: D212.6 (CKO), D213.4 (CKI)
unnamed: D213.1 (SDO), D214.3 (SDI)
unnamed: D213.6 (CKO), D214.4 (CKI)
unnamed: D214.1 (SDO), D215.3 (SDI)
unnamed: D214.6 (CKO), D215.4 (CKI)
unnamed: D215.1 (SDO), D216.3 (SDI)
unnamed: D215.6 (CKO), D216.4 (CKI)
unnamed: D216.1 (SDO), D233.3 (SDI)
unnamed: D216.6 (CKO), D233.4 (CKI)
unnamed: D217.1 (SDO), D218.3 (SDI)
unnamed: D217.6 (CKO), D218.4 (CKI)
unnamed: D218.1 (SDO), D219.3 (SDI)
unnamed: D218.6 (CKO), D219.4 (CKI)
unnamed: D219.1 (SDO), D220.3 (SDI)
unnamed: D219.6 (CKO), D220.4 (CKI)
unnamed: D220.1 (SDO), D221.3 (SDI)
unnamed: D220.6 (CKO), D221.4 (CKI)
unnamed: D221.1 (SDO), D222.3 (SDI)
unnamed: D221.6 (CKO), D222.4 (CKI)
unnamed: D222.1 (SDO), D223.3 (SDI)
unnamed: D222.6 (CKO), D223.4 (CKI)
unnamed: D223.1 (SDO), D224.3 (SDI)
unnamed: D223.6 (CKO), D224.4 (CKI)
unnamed: D224.1 (SDO), D241.3 (SDI)
unnamed: D224.6 (CKO), D241.4 (CKI)
unnamed: D225.1 (SDO), D226.3 (SDI)
unnamed: D225.6 (CKO), D226.4 (CKI)
unnamed: D226.1 (SDO), D227.3 (SDI)
unnamed: D226.6 (CKO), D227.4 (CKI)
unnamed: D227.1 (SDO), D228.3 (SDI)
unnamed: D227.6 (CKO), D228.4 (CKI)
unnamed: D228.1 (SDO), D229.3 (SDI)
unnamed: D228.6 (CKO), D229.4 (CKI)
unnamed: D229.1 (SDO), D230.3 (SDI)
unnamed: D229.6 (CKO), D230.4 (CKI)
unnamed: D230.1 (SDO), D231.3 (SDI)
unnamed: D230.6 (CKO), D231.4 (CKI)
unnamed: D231.1 (SDO), D232.3 (SDI)
unnamed: D231.6 (CKO), D232.4 (CKI)
unnamed: D232.1 (SDO), D249.3 (SDI)
unnamed: D232.6 (CKO), D249.4 (CKI)
unnamed: D233.1 (SDO), D234.3 (SDI)
unnamed: D233.6 (CKO), D234.4 (CKI)
unnamed: D234.1 (SDO), D235.3 (SDI)
unnamed: D234.6 (CKO), D235.4 (CKI)
unnamed: D235.1 (SDO), D236.3 (SDI)
unnamed: D235.6 (CKO), D236.4 (CKI)
unnamed: D236.1 (SDO), D237.3 (SDI)
unnamed: D236.6 (CKO), D237.4 (CKI)
unnamed: D237.1 (SDO), D238.3 (SDI)
unnamed: D237.6 (CKO), D238.4 (CKI)
unnamed: D238.1 (SDO), D239.3 (SDI)
unnamed: D238.6 (CKO), D239.4 (CKI)
unnamed: D239.1 (SDO), D240.3 (SDI)
unnamed: D239.6 (CKO), D240.4 (CKI)
unnamed: D240.1 (SDO), D257.3 (SDI)
unnamed: D240.6 (CKO), D257.4 (CKI)
unnamed: D241.1 (SDO), D242.3 (SDI)
unnamed: D241.6 (CKO), D242.4 (CKI)
unnamed: D242.1 (SDO), D243.3 (SDI)
unnamed: D242.6 (CKO), D243.4 (CKI)
unnamed: D243.1 (SDO), D244.3 (SDI)
unnamed: D243.6 (CKO), D244.4 (CKI)
unnamed: D244.1 (SDO), D245.3 (SDI)
unnamed: D244.6 (CKO), D245.4 (CKI)
unnamed: D245.1 (SDO), D246.3 (SDI)
unnamed: D245.6 (CKO), D246.4 (CKI)
unnamed: D246.1 (SDO), D247.3 (SDI)
unnamed: D246.6 (CKO), D247.4 (CKI)
unnamed: D247.1 (SDO), D248.3 (SDI)
unnamed: D247.6 (CKO), D248.4 (CKI)
unnamed: D248.1 (SDO), D265.3 (SDI)
unnamed: D248.6 (CKO), D265.4 (CKI)
unnamed: D249.1 (SDO), D250.3 (SDI)
unnamed: D249.6 (CKO), D250.4 (CKI)
unnamed: D250.1 (SDO), D251.3 (SDI)
unnamed: D250.6 (CKO), D251.4 (CKI)
unnamed: D251.1 (SDO), D252.3 (SDI)
unnamed: D251.6 (CKO), D252.4 (CKI)
unnamed: D252.1 (SDO), D253.3 (SDI)
unnamed: D252.6 (CKO), D253.4 (CKI)
unnamed: D253.1 (SDO), D254.3 (SDI)
unnamed: D253.6 (CKO), D254.4 (CKI)
unnamed: D254.1 (SDO), D255.3 (SDI)
unnamed: D254.6 (CKO), D255.4 (CKI)
unnamed: D255.1 (SDO), D256.3 (SDI)
unnamed: D255.6 (CKO), D256.4 (CKI)
unnamed: D256.1 (SDO), D273.3 (SDI)
unnamed: D256.6 (CKO), D273.4 (CKI)
unnamed: D257.1 (SDO), D258.3 (SDI)
unnamed: D257.6 (CKO), D258.4 (CKI)
unnamed: D258.1 (SDO), D259.3 (SDI)
unnamed: D258.6 (CKO), D259.4 (CKI)
unnamed: D259.1 (SDO), D260.3 (SDI)
unnamed: D259.6 (CKO), D260.4 (CKI)
unnamed: D260.1 (SDO), D261.3 (SDI)
unnamed: D260.6 (CKO), D261.4 (CKI)
unnamed: D261.1 (SDO), D262.3 (SDI)
unnamed: D261.6 (CKO), D262.4 (CKI)
unnamed: D262.1 (SDO), D263.3 (SDI)
unnamed: D262.6 (CKO), D263.4 (CKI)
unnamed: D263.1 (SDO), D264.3 (SDI)
unnamed: D263.6 (CKO), D264.4 (CKI)
unnamed: D264.1 (SDO), D281.3 (SDI)
unnamed: D264.6 (CKO), D281.4 (CKI)
unnamed: D265.1 (SDO), D266.3 (SDI)
unnamed: D265.6 (CKO), D266.4 (CKI)
unnamed: D266.1 (SDO), D267.3 (SDI)
unnamed: D266.6 (CKO), D267.4 (CKI)
unnamed: D267.1 (SDO), D268.3 (SDI)
unnamed: D267.6 (CKO), D268.4 (CKI)
unnamed: D268.1 (SDO), D269.3 (SDI)
unnamed: D268.6 (CKO), D269.4 (CKI)
unnamed: D269.1 (SDO), D270.3 (SDI)
unnamed: D269.6 (CKO), D270.4 (CKI)
unnamed: D270.1 (SDO), D271.3 (SDI)
unnamed: D270.6 (CKO), D271.4 (CKI)
unnamed: D271.1 (SDO), D272.3 (SDI)
unnamed: D271.6 (CKO), D272.4 (CKI)
unnamed: D272.1 (SDO), D289.3 (SDI)
unnamed: D272.6 (CKO), D289.4 (CKI)
unnamed: D273.1 (SDO), D274.3 (SDI)
unnamed: D273.6 (CKO), D274.4 (CKI)
unnamed: D274.1 (SDO), D275.3 (SDI)
unnamed: D274.6 (CKO), D275.4 (CKI)
unnamed: D275.1 (SDO), D276.3 (SDI)
unnamed: D275.6 (CKO), D276.4 (CKI)
unnamed: D276.1 (SDO), D277.3 (SDI)
unnamed: D276.6 (CKO), D277.4 (CKI)
unnamed: D277.1 (SDO), D278.3 (SDI)
unnamed: D277.6 (CKO), D278.4 (CKI)
unnamed: D278.1 (SDO), D279.3 (SDI)
unnamed: D278.6 (CKO), D279.4 (CKI)
unnamed: D279.1 (SDO), D280.3 (SDI)
unnamed: D279.6 (CKO), D280.4 (CKI)
unnamed: D280.1 (SDO), D297.3 (SDI)
unnamed: D280.6 (CKO), D297.4 (CKI)
unnamed: D281.1 (SDO), D282.3 (SDI)
unnamed: D281.6 (CKO), D282.4 (CKI)
unnamed: D282.1 (SDO), D283.3 (SDI)
unnamed: D282.6 (CKO), D283.4 (CKI)
unnamed: D283.1 (SDO), D284.3 (SDI)
unnamed: D283.6 (CKO), D284.4 (CKI)
unnamed: D284.1 (SDO), D285.3 (SDI)
unnamed: D284.6 (CKO), D285.4 (CKI)
unnamed: D285.1 (SDO), D286.3 (SDI)
unnamed: D285.6 (CKO), D286.4 (CKI)
unnamed: D286.1 (SDO), D287.3 (SDI)
unnamed: D286.6 (CKO), D287.4 (CKI)
unnamed: D287.1 (SDO), D288.3 (SDI)
unnamed: D287.6 (CKO), D288.4 (CKI)
unnamed: D288.1 (SDO), D305.3 (SDI)
unnamed: D288.6 (CKO), D305.4 (CKI)
unnamed: D289.1 (SDO), D290.3 (SDI)
unnamed: D289.6 (CKO), D290.4 (CKI)
unnamed: D290.1 (SDO), D291.3 (SDI)
unnamed: D290.6 (CKO), D291.4 (CKI)
unnamed: D291.1 (SDO), D292.3 (SDI)
unnamed: D291.6 (CKO), D292.4 (CKI)
unnamed: D292.1 (SDO), D293.3 (SDI)
unnamed: D292.6 (CKO), D293.4 (CKI)
unnamed: D293.1 (SDO), D294.3 (SDI)
unnamed: D293.6 (CKO), D294.4 (CKI)
unnamed: D294.1 (SDO), D295.3 (SDI)
unnamed: D294.6 (CKO), D295.4 (CKI)
unnamed: D295.1 (SDO), D296.3 (SDI)
unnamed: D295.6 (CKO), D296.4 (CKI)
unnamed: D296.1 (SDO), D313.3 (SDI)
unnamed: D296.6 (CKO), D313.4 (CKI)
unnamed: D297.1 (SDO), D298.3 (SDI)
unnamed: D297.6 (CKO), D298.4 (CKI)
unnamed: D298.1 (SDO), D299.3 (SDI)
unnamed: D298.6 (CKO), D299.4 (CKI)
unnamed: D299.1 (SDO), D300.3 (SDI)
unnamed: D299.6 (CKO), D300.4 (CKI)
unnamed: D300.1 (SDO), D301.3 (SDI)
unnamed: D300.6 (CKO), D301.4 (CKI)
unnamed: D301.1 (SDO), D302.3 (SDI)
unnamed: D301.6 (CKO), D302.4 (CKI)
unnamed: D302.1 (SDO), D303.3 (SDI)
unnamed: D302.6 (CKO), D303.4 (CKI)
unnamed: D303.1 (SDO), D304.3 (SDI)
unnamed: D303.6 (CKO), D304.4 (CKI)
unnamed: D304.1 (SDO), D321.3 (SDI)
unnamed: D304.6 (CKO), D321.4 (CKI)
unnamed: D305.1 (SDO), D306.3 (SDI)
unnamed: D305.6 (CKO), D306.4 (CKI)
unnamed: D306.1 (SDO), D307.3 (SDI)
unnamed: D306.6 (CKO), D307.4 (CKI)
unnamed: D307.1 (SDO), D308.3 (SDI)
unnamed: D307.6 (CKO), D308.4 (CKI)
unnamed: D308.1 (SDO), D309.3 (SDI)
unnamed: D308.6 (CKO), D309.4 (CKI)
unnamed: D309.1 (SDO), D310.3 (SDI)
unnamed: D309.6 (CKO), D310.4 (CKI)
unnamed: D310.1 (SDO), D311.3 (SDI)
unnamed: D310.6 (CKO), D311.4 (CKI)
unnamed: D311.1 (SDO), D312.3 (SDI)
unnamed: D311.6 (CKO), D312.4 (CKI)
unnamed: D312.1 (SDO), D329.3 (SDI)
unnamed: D312.6 (CKO), D329.4 (CKI)
unnamed: D313.1 (SDO), D314.3 (SDI)
unnamed: D313.6 (CKO), D314.4 (CKI)
unnamed: D314.1 (SDO), D315.3 (SDI)
unnamed: D314.6 (CKO), D315.4 (CKI)
unnamed: D315.1 (SDO), D316.3 (SDI)
unnamed: D315.6 (CKO), D316.4 (CKI)
unnamed: D316.1 (SDO), D317.3 (SDI)
unnamed: D316.6 (CKO), D317.4 (CKI)
unnamed: D317.1 (SDO), D318.3 (SDI)
unnamed: D317.6 (CKO), D318.4 (CKI)
unnamed: D318.1 (SDO), D319.3 (SDI)
unnamed: D318.6 (CKO), D319.4 (CKI)
unnamed: D319.1 (SDO), D320.3 (SDI)
unnamed: D319.6 (CKO), D320.4 (CKI)
unnamed: D320.1 (SDO), D337.3 (SDI)
unnamed: D320.6 (CKO), D337.4 (CKI)
unnamed: D321.1 (SDO), D322.3 (SDI)
unnamed: D321.6 (CKO), D322.4 (CKI)
unnamed: D322.1 (SDO), D323.3 (SDI)
unnamed: D322.6 (CKO), D323.4 (CKI)
unnamed: D323.1 (SDO), D324.3 (SDI)
unnamed: D323.6 (CKO), D324.4 (CKI)
unnamed: D324.1 (SDO), D325.3 (SDI)
unnamed: D324.6 (CKO), D325.4 (CKI)
unnamed: D325.1 (SDO), D326.3 (SDI)
unnamed: D325.6 (CKO), D326.4 (CKI)
unnamed: D326.1 (SDO), D327.3 (SDI)
unnamed: D326.6 (CKO), D327.4 (CKI)
unnamed: D327.1 (SDO), D328.3 (SDI)
unnamed: D327.6 (CKO), D328.4 (CKI)
unnamed: D328.1 (SDO), D345.3 (SDI)
unnamed: D328.6 (CKO), D345.4 (CKI)
unnamed: D329.1 (SDO), D330.3 (SDI)
unnamed: D329.6 (CKO), D330.4 (CKI)
unnamed: D330.1 (SDO), D331.3 (SDI)
unnamed: D330.6 (CKO), D331.4 (CKI)
unnamed: D331.1 (SDO), D332.3 (SDI)
unnamed: D331.6 (CKO), D332.4 (CKI)
unnamed: D332.1 (SDO), D333.3 (SDI)
unnamed: D332.6 (CKO), D333.4 (CKI)
unnamed: D333.1 (SDO), D334.3 (SDI)
unnamed: D333.6 (CKO), D334.4 (CKI)
unnamed: D334.1 (SDO), D335.3 (SDI)
unnamed: D334.6 (CKO), D335.4 (CKI)
unnamed: D335.1 (SDO), D336.3 (SDI)
unnamed: D335.6 (CKO), D336.4 (CKI)
unnamed: D336.1 (SDO), D353.3 (SDI)
unnamed: D336.6 (CKO), D353.4 (CKI)
unnamed: D337.1 (SDO), D338.3 (SDI)
unnamed: D337.6 (CKO), D338.4 (CKI)
unnamed: D338.1 (SDO), D339.3 (SDI)
unnamed: D338.6 (CKO), D339.4 (CKI)
unnamed: D339.1 (SDO), D340.3 (SDI)
unnamed: D339.6 (CKO), D340.4 (CKI)
unnamed: D340.1 (SDO), D341.3 (SDI)
unnamed: D340.6 (CKO), D341.4 (CKI)
unnamed: D341.1 (SDO), D342.3 (SDI)
unnamed: D341.6 (CKO), D342.4 (CKI)
unnamed: D342.1 (SDO), D343.3 (SDI)
unnamed: D342.6 (CKO), D343.4 (CKI)
unnamed: D343.1 (SDO), D344.3 (SDI)
unnamed: D343.6 (CKO), D344.4 (CKI)
unnamed: D344.1 (SDO), D361.3 (SDI)
unnamed: D344.6 (CKO), D361.4 (CKI)
unnamed: D345.1 (SDO), D346.3 (SDI)
unnamed: D345.6 (CKO), D346.4 (CKI)
unnamed: D346.1 (SDO), D347.3 (SDI)
unnamed: D346.6 (CKO), D347.4 (CKI)
unnamed: D347.1 (SDO), D348.3 (SDI)
unnamed: D347.6 (CKO), D348.4 (CKI)
unnamed: D348.1 (SDO), D349.3 (SDI)
unnamed: D348.6 (CKO), D349.4 (CKI)
unnamed: D349.1 (SDO), D350.3 (SDI)
unnamed: D349.6 (CKO), D350.4 (CKI)
unnamed: D350.1 (SDO), D351.3 (SDI)
unnamed: D350.6 (CKO), D351.4 (CKI)
unnamed: D351.1 (SDO), D352.3 (SDI)
unnamed: D351.6 (CKO), D352.4 (CKI)
unnamed: D352.1 (SDO), D369.3 (SDI)
unnamed: D352.6 (CKO), D369.4 (CKI)
unnamed: D353.1 (SDO), D354.3 (SDI)
unnamed: D353.6 (CKO), D354.4 (CKI)
unnamed: D354.1 (SDO), D355.3 (SDI)
unnamed: D354.6 (CKO), D355.4 (CKI)
unnamed: D355.1 (SDO), D356.3 (SDI)
unnamed: D355.6 (CKO), D356.4 (CKI)
unnamed: D356.1 (SDO), D357.3 (SDI)
unnamed: D356.6 (CKO), D357.4 (CKI)
unnamed: D357.1 (SDO), D358.3 (SDI)
unnamed: D357.6 (CKO), D358.4 (CKI)
unnamed: D358.1 (SDO), D359.3 (SDI)
unnamed: D358.6 (CKO), D359.4 (CKI)
unnamed: D359.1 (SDO), D360.3 (SDI)
unnamed: D359.6 (CKO), D360.4 (CKI)
unnamed: D360.1 (SDO), D377.3 (SDI)
unnamed: D360.6 (CKO), D377.4 (CKI)
unnamed: D361.1 (SDO), D362.3 (SDI)
unnamed: D361.6 (CKO), D362.4 (CKI)
unnamed: D362.1 (SDO), D363.3 (SDI)
unnamed: D362.6 (CKO), D363.4 (CKI)
unnamed: D363.1 (SDO), D364.3 (SDI)
unnamed: D363.6 (CKO), D364.4 (CKI)
unnamed: D364.1 (SDO), D365.3 (SDI)
unnamed: D364.6 (CKO), D365.4 (CKI)
unnamed: D365.1 (SDO), D366.3 (SDI)
unnamed: D365.6 (CKO), D366.4 (CKI)
unnamed: D366.1 (SDO), D367.3 (SDI)
unnamed: D366.6 (CKO), D367.4 (CKI)
unnamed: D367.1 (SDO), D368.3 (SDI)
unnamed: D367.6 (CKO), D368.4 (CKI)
unnamed: D369.1 (SDO), D370.3 (SDI)
unnamed: D369.6 (CKO), D370.4 (CKI)
unnamed: D370.1 (SDO), D371.3 (SDI)
unnamed: D370.6 (CKO), D371.4 (CKI)
unnamed: D371.1 (SDO), D372.3 (SDI)
unnamed: D371.6 (CKO), D372.4 (CKI)
unnamed: D372.1 (SDO), D373.3 (SDI)
unnamed: D372.6 (CKO), D373.4 (CKI)
unnamed: D373.1 (SDO), D374.3 (SDI)
unnamed: D373.6 (CKO), D374.4 (CKI)
unnamed: D374.1 (SDO), D375.3 (SDI)
unnamed: D374.6 (CKO), D375.4 (CKI)
unnamed: D375.1 (SDO), D376.3 (SDI)
unnamed: D375.6 (CKO), D376.4 (CKI)
unnamed: D377.1 (SDO), D378.3 (SDI)
unnamed: D377.6 (CKO), D378.4 (CKI)
unnamed: D378.1 (SDO), D379.3 (SDI)
unnamed: D378.6 (CKO), D379.4 (CKI)
unnamed: D379.1 (SDO), D380.3 (SDI)
unnamed: D379.6 (CKO), D380.4 (CKI)
unnamed: D380.1 (SDO), D381.3 (SDI)
unnamed: D380.6 (CKO), D381.4 (CKI)
unnamed: D381.1 (SDO), D382.3 (SDI)
unnamed: D381.6 (CKO), D382.4 (CKI)
unnamed: D382.1 (SDO), D383.3 (SDI)
unnamed: D382.6 (CKO), D383.4 (CKI)
unnamed: D383.1 (SDO), D384.3 (SDI)
unnamed: D383.6 (CKO), D384.4 (CKI)

Notes on the sheet:
SK9822 LED Matrix
