mattlokes/mqttDisplay/pcb/mqttDisplay/mqttDisplay.kicad_pcb

## KiCad design pcb/mqttDisplay/mqttDisplay.kicad_pcb (continued)

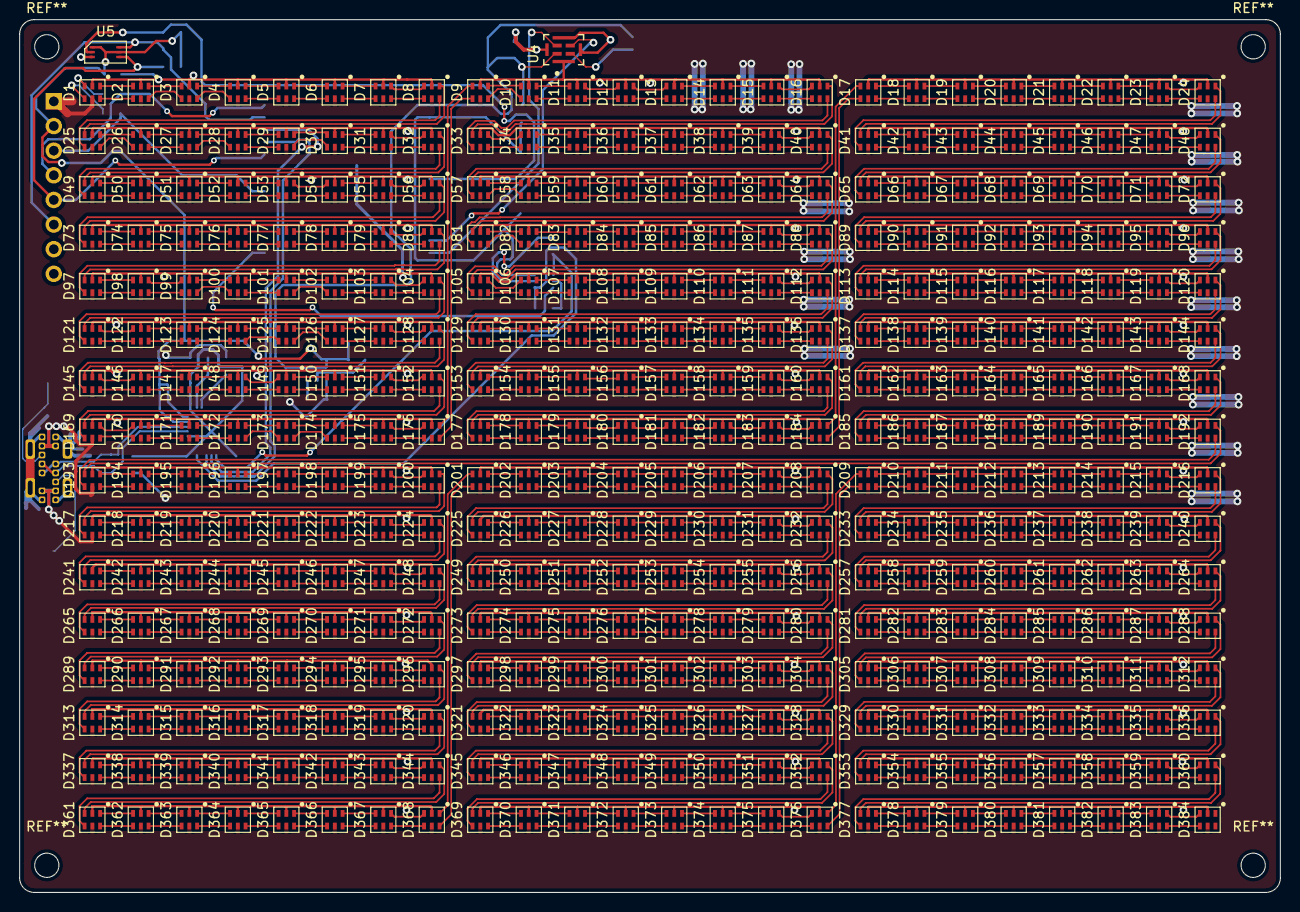
[picture p10: board mqttDisplay.kicad_pcb from above]

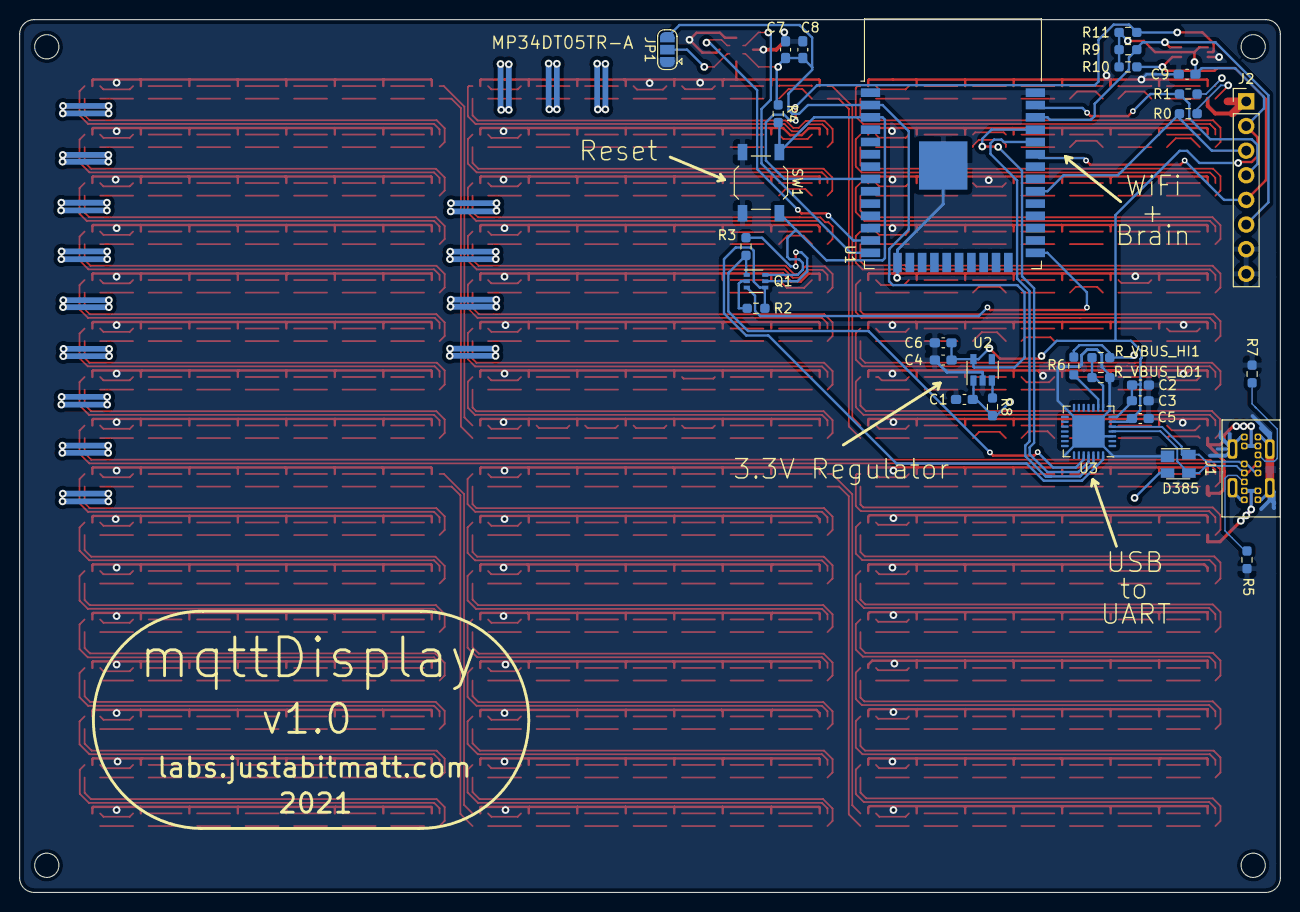
[picture p11: board mqttDisplay.kicad_pcb from below]

Board: 2 copper layers, 130.0 x 90.0 mm, 418 parts (32 on the bottom side), 794 nets.
