mattlokes/mqttDisplay/(commit log)

2021-02-14 Makeflow can initialise the ESP32 with micropython using targt esp32-init
2021-02-14 Add working colour to makefile target prints, add python file upload/serial attach targets
2021-02-14 MQTT subscribing to correct topics and printing new message values
    [boot.py, main.py]
2021-02-14 Get Display working across 4 boards, concept proven
2021-03-14 Add V1.0 PCB
    [mqttDisplay-B_Cu.gbr, mqttDisplay-B_Mask.gbr, mqttDisplay-B_Paste.gbr, mqttDisplay-B_SilkS.gbr, mqttDisplay-Edge_Cuts.gbr, mqttDisplay-F_Cu.gbr, mqttDisplay-F_Mask.gbr, mqttDisplay-F_Paste.gbr]
2021-03-28 Add interactive bom
2021-03-28 Add case STLs and 3mf files
    [baffle.stl, main.3mf, main.stl, stand.3mf, stand_left.stl, stand_right.stl]
2021-03-28 Add schematic
2021-04-05 Add Animation Buffer Objects to allow easier anmiation programming, add Battery guage graphic
2021-04-11 KiCaD project changes
2021-04-11 Add Clock view and fix some of the view control round robin system
    [clockView.py, main.py, view.py]
